terabitesyuex/ENGR1000P2_Mars-Scout-Rover/evidence/hardware/vehicle_assembly_2026-07-23/vehicle_front_right.jpg

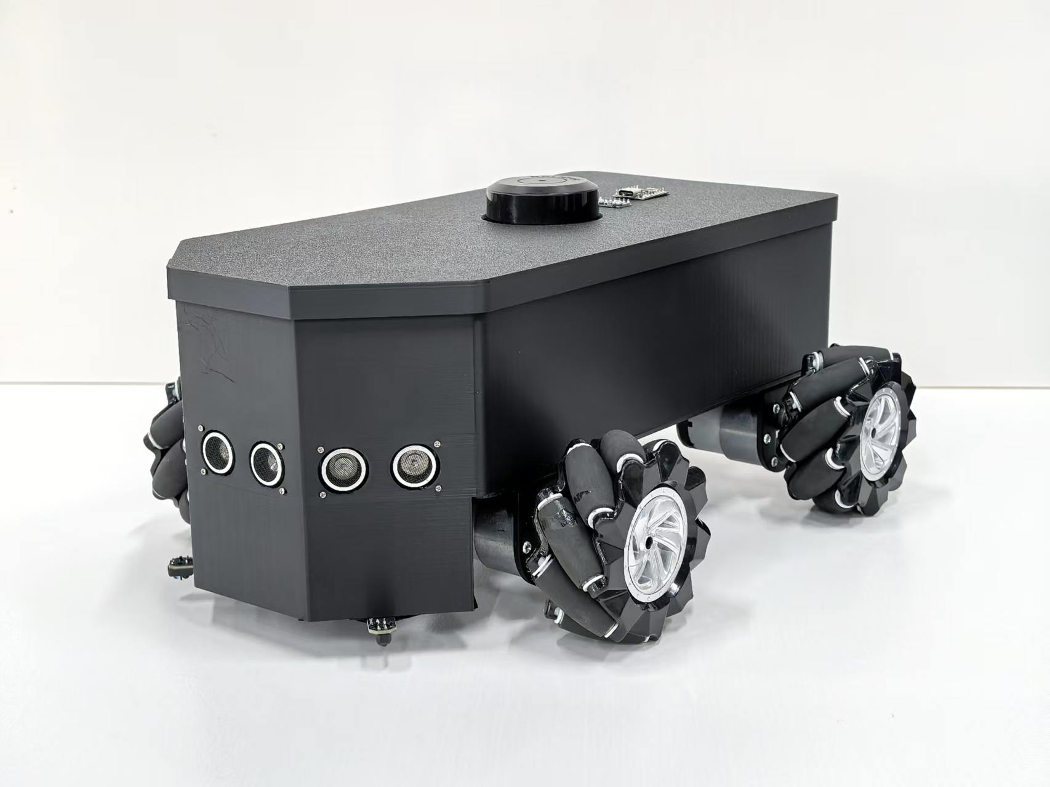
evidence/hardware/vehicle_assembly_2026-07-23/vehicle_front_right.jpg
