terabitesyuex/ENGR1000P2_Mars-Scout-Rover/README.md

# ENGR1000P2 Mars Scout Rover

This repository supports a low-cost Mars Scout Rover using an STM32 mecanum-wheel chassis, an ESP32 communication layer, multiple sensors, and PC visualization/recording tools.

Mandatory baseline functions are nearby-obstacle detection, local stop/turn collision avoidance, rover and sensor data acquisition, WiFi data transmission to a computer, real-time 2D LiDAR/radar-style display, reproducible evidence through recording/replay, and safe behavior when communication or sensors fail.

Major enhancements are encoder/IMU-assisted pose estimation, short-range accumulated 2D environment mapping, and environmental-change indication using illuminance, temperature, and atmospheric-pressure measurements. The current inventory has exactly one physical RPLIDAR C1M1-R2; dual-C1 work is not current scope. ROS and a vehicle-mounted Linux computer are not required.

The user reports that the complete vehicle has been assembled to the wiring
plan. A 2026-07-23 evidence batch records exterior/underside sensor photographs,
vehicle front, installed C1/GY-521, 79 mm wheel diameter, 190 mm wheelbase,
217 mm track width, and an 85.8 mm C1 scan-plane height above the chassis upper
surface. Electrical acceptance, controller wiring, signs, calibration, and
controlled operation remain UNVERIFIED.
The current accelerated scope is a presentation-ready vehicle demo. A supplied
hardware-team obstacle target is being integrated through the fail-closed
[`vehicle demo obstacle guide`](docs/vehicle_demo_obstacle_integration.md).
Formal Phase 4C background remains in
[`docs/near_term_vehicle_bringup_handoff.md`](docs/near_term_vehicle_bringup_handoff.md).

## Repository Layout

- `firmware/openrf1/`: OpenRF1 firmware, isolated bring-up applications, centralized rover configuration, and the embedded motor/encoder/mecanum boundary.
- `firmware/include/` and `firmware/src/`: portable firmware interfaces and transport/processing foundations retained for later integration.
- `pc/`: installable PC tools, parsers, recording/replay, visualization, simulations, and automated tests.
- `pc_direct/`: operator-driven direct C1 diagnostics and the official SDK probe.
- `docs/`, `evidence/`, and `tools/`: current hardware guidance, recorded evidence, and deterministic verification.

装车使用 [`docs/openrf1_rover_wiring_plan_zh.md`](docs/openrf1_rover_wiring_plan_zh.md)；
工程依据和状态边界使用
[`docs/openrf1_rover_wiring_plan.md`](docs/openrf1_rover_wiring_plan.md)。

The repository root is the single source of truth. Historical nested repository copies and README-only future-module placeholders are intentionally excluded.

## Current Phase

- Phase 0: complete.
- Phase 1: complete.
- Phase 2.1: synthetic scan pipeline and unified `ScanFrame` model complete.
- Phase 2.2: rover-frame coordinate transforms complete.
- Automated phase verification foundation: complete.
- Phase 2.3: synthetic LiDAR visualization complete.
- Phase 2.4: multi-sensor JSONL recording, replay, reproducible synthetic datasets, hardware-inventory update, and plan rebaseline complete.
- Phase 2.5: PC-direct C1 driver boundary, standard scan-node parsing, bounded capture into JSONL, replay, visualization, and committed physical-evidence validation complete. The one `c1_1` has MANUAL_EVIDENCE_VERIFIED physical acquisition and external RViz `/scan` visualization; electrical safety, vendor health, wall-clock timing, absolute accuracy, and rover integration remain UNVERIFIED.
- Phase 3.1: STM32 low-rate sensor telemetry protocol, deterministic simulator, strict parser, recording bridge, CLI workflows, and manual bring-up checklist complete.
- Phase 3.2A: OpenRF1 STM32F103RCT6 + GY-302/BH1750 firmware foundation, mocked PC serial-capture workflow, documentation, phase verification, and recorded BH1750-only physical evidence complete. Absolute lux calibration remains UNVERIFIED.
- Phase 3.2B: OpenRF1 multisensor and communications software foundation, isolated full-hardware Keil project, PC contracts, simulators, parser/recording support, and software verification support added. Physical wiring and live sensor/link behavior remain UNVERIFIED.
- Phase 3.2C: isolated OpenRF1 BMP280-only bring-up firmware, Keil target, host-side BMP280 register/telemetry tests, verifier support, and recorded BMP280 physical evidence complete. Absolute temperature and pressure accuracy remain UNVERIFIED.
- Phase 3.2D: isolated OpenRF1 MPU6050-only bring-up firmware foundation, Keil target, host-side MPU6050 register/telemetry tests, verifier support, startup gyro-bias calibration software, and recorded isolated manual evidence complete. Absolute acceleration/gyro accuracy, calibration motion rejection, final rover-frame axis alignment, shared-I2C concurrency, and full-hardware operation remain UNVERIFIED.
- Phase 3.2E: isolated OpenRF1 HC-SR04-only bring-up firmware, bounded telemetry framing, strict parser, dedicated mock capture, fixtures, evidence lifecycle, A/B handoffs, PA5/PA4/CN6/TIM6 vendor-documented design lock, required external ECHO divider, Keil target, tests, and verifier support complete. Physical wiring, trigger/echo pulses, real distance data, timeout behavior, and distance accuracy remain UNVERIFIED.
- Phase 3.2F: isolated OpenRF1 ground-sensor firmware foundation and TCRT5000 evidence closeout complete. A's evidence verifies the isolated build/flash, PC4/PC5 signal connections, labelled 3.3 V/common-GND connections, both modules' raw/debounced response, four 100-frame gap-free captures, and exact 50 ms steady-state timestamps. A later user-supplied photograph confirms the Hall module is mounted under the rover and that the photograph's top edge is rover-forward. Corrected front/rear/left/right Hall-to-body-boundary clearances are 185/135/75/75 mm; supplied 95/95 mm front/rear axle distances and 65 mm floor height establish Hall x=0 mm, y=0 mm, z=+25.5 mm relative to the wheel-centre `base_link`, using the supplied 39.5 mm loaded wheel radius. Electrical measurements, sensing face, polarity semantics, magnetic behavior/working distance, long-duration operation, and full-rover operation remain UNVERIFIED.
- Phase 4A: standard X-layout mecanum kinematics, explicit wheel-side encoder conversion, body-twist estimation, exact SE(2) odometry integration, deterministic simulation, version-1 telemetry/recording compatibility, tests, documentation, and verifier support complete as a software-only foundation. Supplied geometry is recorded at 0.1 mm precision; encoder resolution/signs, roller orientation, hardware acquisition, geometry tolerance, and physical odometry accuracy remain UNVERIFIED.
- Phase 4B: validated body-motion commands, proportional wheel desaturation, acceleration limiting, four independent PID controllers, command watchdog, local safety arbitration, deterministic synthetic wheel plants, version-1 telemetry/recording additions, CLI, tests, documentation, and verifier support complete as a software-only foundation. Real motor/encoder behavior, PWM mapping, physical PID tuning, stopping distance, and closed-loop performance remain UNVERIFIED.
- OpenRF1 rover-control firmware boundary: centralized UNKNOWN hardware mappings, injected four-channel Motor and Encoder HALs, fixed-point mecanum inverse kinematics, and an isolated ARM Compiler 6 compile target are present. The target uses inert backends and must not be flashed as operational rover firmware; real PWM, encoder acquisition, motion, and hardware integration remain UNVERIFIED.
- Accelerated vehicle-demo obstacle foundation: isolated real TIM8 motor output,
  nonblocking staggered three-HC-SR04 acquisition, explicit ARM/START,
  fail-closed sensor handling, command heartbeat watchdog, strict JSONL, focused
  tests, and a dedicated Keil project are present. The current demo mapping is
  user-confirmed as left PB9/PB8, centre PB5/PB4, and right PD2/PC11. All three
  ECHO paths are user-reported operational without dividers, but their actual
  voltages and electrical safety remain unverified. The same target now has a
  read-only four-connector encoder foundation using TIM5/TIM3/TIM2-full-remap/
  TIM4, 50 ms raw/delta/cumulative JSONL, and strict offline inspection. It does
  not assign physical wheel roles or direction signs, and encoder data cannot
  control motion.

Phases 4A and 4B themselves do not implement hardware adapters. VehicleDemo now contains a software-verified read-only timer/counter encoder adapter, but its physical operation is unverified and it is not yet connected to Phase 4A odometry or Phase 4B control. ESP32 WiFi firmware, mapping, SLAM, navigation, C1 integrated-rover validation, MPU6050 fusion, physical closed-loop motion, and full multisensor hardware integration remain incomplete. Automated tests do not access real COM ports, USB devices, GPIO, timer peripherals, I2C, encoders, motors, flashing tools, WiFi, or sensors.

Phase 4C now also has a dedicated `OpenRF1_Encoder_Bringup` firmware and Keil
project. It is USART1-TX-only, samples neutral CN1-CN4 16-bit counters every
100 ms, reuses the strict offline encoder inspector, and contains no TIM8,
motor GPIO, sensor path, or command receiver. The ARM Compiler 6.24 build
completed with 0 errors and 0 warnings. No COM port was opened and nothing was
flashed; see `docs/openrf1_encoder_bringup.md` for the manual gate.

The next software-only subset, `OpenRF1_Motor_Bringup`, is also present. It
starts unconfigured with TIM8 CCR=0, CCER=0, and MOE off; requires one explicit
CN, two signs, a user-reviewed duty ceiling, watchdog, ARM, and RUN; and removes
output on all command/transport/watchdog failures. Its ARM Compiler 6.24 build
also reports 0 errors and 0 warnings. No physical safety or operation is
claimed; see `docs/openrf1_motor_bringup.md`.
The fill-in preflight and evidence form is
`docs/phase4c_manual_test_card_zh.md`.

## Phase 4A Mecanum Kinematics and Odometry

Phase 4A preserves `+x` forward, `+y` left, and positive counterclockwise yaw. It implements the documented standard X-layout equations in wheel order `front_left`, `front_right`, `rear_left`, `rear_right`. Positive wheel rotation is mathematical and independent of physical wiring or encoder polarity.

Callers must explicitly provide finite positive `wheel_radius_m`, `half_length_m`, `half_width_m`, and wheel-side `counts_per_wheel_revolution`, plus four direction multipliers restricted to `+1` or `-1`. No physical geometry, encoder resolution, gear ratio, counter width, or sign is defaulted.

Generate a deterministic fixture using values explicitly labelled synthetic, not rover measurements:

```powershell
python -m rplidar_c1_tools.cli simulate-mecanum-odometry --wheel-radius-m 0.05 --half-length-m 0.18 --half-width-m 0.16 --counts-per-wheel-revolution 2048 --front-left-direction 1 --front-right-direction 1 --rear-left-direction 1 --rear-right-direction 1 --scenario combined_curved_motion --steps 5 --interval-ms 100 --output .verification\phase4a\mecanum_odometry.jsonl --overwrite
```

See `docs/phase4a_mecanum_kinematics_odometry_foundation.md` for formulas, encoder interpretation, SE(2) integration, telemetry/recording fields, and the complete UNVERIFIED hardware boundary.

## Phase 4B Closed-Loop Motion Control

Phase 4B reuses Phase 4A kinematics and adds pure command validation, proportional four-wheel desaturation, per-wheel angular-acceleration limits, derivative-on-measurement PID with conditional anti-windup, four independent controller states, supplied-timestamp watchdog logic, explicit permit-or-stop safety precedence, and a synthetic first-order wheel plant. Normalized effort is dimensionless mathematical output, not PWM or motor voltage.

All geometry, limits, PID values, and plant values used by the CLI are explicit synthetic fixtures:

```powershell
python -m rplidar_c1_tools.cli simulate-motion-control --wheel-radius-m 0.05 --half-length-m 0.18 --half-width-m 0.16 --max-wheel-speed-rad-s 20 --wheel-acceleration-rad-s2 10 --pid-kp 0.05 --pid-ki 0.02 --pid-kd 0 --pid-output-min -1 --pid-output-max 1 --pid-integral-min -2 --pid-integral-max 2 --plant-gain-rad-s-per-effort 20 --plant-time-constant-s 0.2 --command-timeout-ms 250 --scenario combined_curved_motion --steps 20 --interval-ms 100 --output .verification\phase4b\motion_control.jsonl --overwrite
```

See `docs/phase4b_closed_loop_motion_control_foundation.md` for equations, safety precedence, telemetry additions, simulator scenarios, and the UNVERIFIED physical boundary.

## Confirmed Hardware Inventory

Ranging:

- RPLIDAR C1M1-R2 x1.
- HC-SR04 ultrasonic sensor x3.

Motion and pose:

- Wheel encoders associated with four drive motors.
- MPU6050 inertial measurement unit x1.

Ground and landmark:

- TCRT5000 reflective infrared sensor x2 for edge/drop detection.
- Hall sensor module x1 for magnetic landmark/checkpoint detection.

Environment:

- BH1750 illuminance sensor x1.
- BMP280 temperature/pressure sensor x1.

Controllers and chassis:

- STM32 controller board x1.
- ESP32 board x1.
- Li-ion battery pack x1: seller-documented 11.1 V, 7800 mAh, 5C, 12.6 V fully
  charged, 70 x 55 x 23 mm, DC 5.5 x 2.5 mm male connector; polarity and BMS
  current limits remain UNVERIFIED.
- Battery charger x1: seller-documented 12.6 V/1 A, DC 5.5 x 2.5 mm female;
  charge only while the pack is disconnected from the rover.
- Four encoded motors.
- Four mecanum wheels.
- Existing rover chassis.
- Supplied geometry record: 79 mm loaded wheel diameter, 190 mm wheelbase,
  217 mm track width. These are not yet physically tolerance-calibrated.

Use neutral sensor IDs until installation is physically verified: `c1_1`, `ultrasonic_1`, `ultrasonic_2`, `ultrasonic_3`, `tcrt5000_1`, `tcrt5000_2`, `bh1750_1`, `bmp280_1`, `mpu6050_1`, and `hall_1`. Historical version-1 recordings and explicitly synthetic compatibility fixtures may contain `c1_2`.

Exactly one physical RPLIDAR C1M1-R2 is available. `c1_1` is the only current physical LiDAR sensor and the only active LiDAR integration target. PC-direct acquisition and visualization are MANUAL_EVIDENCE_VERIFIED; full physical acceptance remains partial. There is no current requirement to compare two physical units, no current dual-C1 integration phase, and no current dual-C1 feasibility evaluation. A future second C1 requires an explicit inventory change and new electrical, power, UART, bandwidth, buffering, timing, mounting, synchronization, and safety validation.

Committed Phase 2.5 evidence preserves 102 physical scan records containing 36,720 points plus a hash-locked RViz screenshot. Offline validation confirms schema, identity, sequence, point shape, hashes, and privacy without opening a serial port. The capture timestamps are tool-generated, and the raw bundle retains quality-zero and above-12 m outliers, so scan timing, clean-packet rate, absolute accuracy, electrical safety, and integrated operation remain UNVERIFIED.

## Phase 3.1 STM32 Sensor Telemetry

Phase 3.1 defines the transport-facing protocol `mars_scout_stm32_sensor_telemetry` version `1` for future STM32 low-rate sensor messages. It is newline-delimited UTF-8 JSON for software bring-up and later ESP32 forwarding. The persistent PC recording format remains `mars_scout_multisensor_recording` version `1`.

Generate deterministic STM32 telemetry:

```powershell
python -m rplidar_c1_tools.cli simulate-stm32-sensors --cycles 5 --scenario nominal --output .verification\phase3.1\synthetic_stm32_telemetry.jsonl --overwrite
```

Inspect telemetry:

```powershell
python -m rplidar_c1_tools.cli inspect-stm32-telemetry --input .verification\phase3.1\synthetic_stm32_telemetry.jsonl --output .verification\phase3.1\telemetry_inspection.txt
```

Convert telemetry into the existing Phase 2.4 recording format:

```powershell
python -m rplidar_c1_tools.cli record-stm32-telemetry --input .verification\phase3.1\synthetic_stm32_telemetry.jsonl --output .verification\phase3.1\converted_multisensor_recording.jsonl --overwrite
```

Supported Phase 3.1 sensor message types are `ultrasonic`, `ground_edge`, `hall_landmark`, `illuminance`, and `barometer`. HC-SR04 timeout is explicit and is not converted to distance zero. TCRT5000 and Hall raw states remain visible while polarity is UNVERIFIED. BH1750 and BMP280 support environmental-change indication only; reliable dust-storm detection is not claimed.

## Phase 3.2A OpenRF1 BH1750 Foundation

Phase 3.2A locks the software target for the first real STM32 sensor path: OpenRF1 robot controller, STM32F103RCT6, software I2C on PB1/SCL and PC3/SDA, GY-302/BH1750 sensor ID `bh1750_1`, public 7-bit address `0x23`, and USART1 PA9 TX / PA10 RX at 115200 baud 8N1. Recorded manual evidence marks firmware flash, CH340/USART1 telemetry, BH1750 communication at configured address `0x23`, a 500 ms telemetry period, and physical light response as MANUAL_EVIDENCE_VERIFIED; absolute lux calibration remains UNVERIFIED.

Generate deterministic BH1750-only telemetry:

```powershell
python -m rplidar_c1_tools simulate-bh1750-telemetry --samples 5 --output .verification\phase3.2a\mocked_bh1750_source.jsonl --overwrite
```

Capture from a mocked serial source and convert to the Phase 2.4 recording format:

```powershell
python -m rplidar_c1_tools capture-stm32-serial --mock-input .verification\phase3.2a\mocked_bh1750_source.jsonl --max-messages 5 --telemetry-output .verification\phase3.2a\mocked_bh1750_telemetry.jsonl --recording-output .verification\phase3.2a\mocked_bh1750_recording.jsonl --overwrite
```

Manual capture requires an operator-selected CH340 COM port; software never guesses a port:

```powershell
python -m rplidar_c1_tools capture-stm32-serial --port <USER_VERIFIED_COM_PORT> --baud 115200 --duration 30 --telemetry-output bh1750_telemetry.jsonl --recording-output bh1750_recording.jsonl --overwrite
```

Firmware source lives under `firmware/openrf1/app/`. It is application-layer source for the vendor OpenRF1 Keil MDK/uVision 5 STM32F103RC project. The committed Phase 3.2A evidence validates a manually recorded BH1750-only run; automated tests still use mocked/file-backed inputs and do not physically access the device.

## Phase 3.2B OpenRF1 Full-Hardware Foundation

Phase 3.2B keeps the Phase 3.2A BH1750-only project intact and adds a separate full-hardware firmware foundation under `firmware/openrf1/full_hardware/` with project file `firmware/openrf1/keil/OpenRF1_FullHardware.uvprojx`. The new Keil output is isolated under `Objects_FullHardware/` as `OpenRF1_FullHardware.hex`.

Software foundations include shared software-I2C transactions for BH1750/BMP280/MPU6050, BMP280 and MPU6050 pure conversion logic, raw digital filtering for TCRT5000/Hall, nonblocking HC-SR04 state machines, RPLIDAR C1 USART2 byte transport counters, and a versioned STM32-to-ESP32 USART3 binary frame contract. Phase 3.2B uses module-specific electrical evidence: BH1750 and MPU6050 module VCC -> 5 V, BMP280 and TCRT5000 VCC -> 3.3 V, Hall module -> 5 V with output measurement required, ESP32 external 5 V isolated from USB, and HC-SR04 Echo protection conditional on measured VOH. USART2/USART3 connector-to-MCU pins, PWM channel GPIOs, line-input GPIOs, BMP280/MPU6050 ACKs, polarity, power integrity, and real full-system sensor data remain UNVERIFIED.

Generate a deterministic Phase 3.2B telemetry fixture:

```powershell
python -m rplidar_c1_tools.cli simulate-stm32-sensors --cycles 2 --scenario phase32b_full_foundation --output .verification\phase3.2b\phase32b_full_telemetry.jsonl --overwrite
```

Convert it to the existing recording format:

```powershell
python -m rplidar_c1_tools.cli record-stm32-telemetry --input .verification\phase3.2b\phase32b_full_telemetry.jsonl --output .verification\phase3.2b\phase32b_full_recording.jsonl --overwrite
```

## Phase 3.2C OpenRF1 BMP280 Bring-Up

Phase 3.2C adds a BMP280-only physical bring-up target under `firmware/openrf1/bmp280_bringup/` with Keil project `firmware/openrf1/keil/OpenRF1_BMP280_Bringup.uvprojx`. Its output is isolated under `Objects_BMP280_Bringup/` as `OpenRF1_BMP280_Bringup.hex`.

The dedicated firmware expects only `bmp280_1` on software I2C PB1/SCL and PC3/SDA: VCC -> 3.3 V, GND -> GND, CSB -> 3.3 V for I2C mode, and SDO -> GND for address `0x76`. It probes `0x76`, reads chip ID register `0xD0`, expects `0x58`, reads calibration, writes `config = 0x80`, writes `ctrl_meas = 0x27`, and emits `environmental` JSONL every 500 ms on USART1 PA9/PA10 at 115200 8N1.

Committed evidence in `evidence/phase3.2c/` marks isolated BMP280 firmware flashing, USART1/CH340 JSONL telemetry, I2C ACK at `0x76`, chip ID `0x58`, calibration-register path for compensated output, `ctrl_meas = 0x27` and `config = 0x80` readback, continuous compensated temperature/pressure telemetry, exact 500 ms periodicity, and a stable 30-second capture as PHYSICAL_EVIDENCE_VERIFIED. Repository automation validates the evidence offline; it does not flash, open a COM port, or access hardware.

Absolute temperature accuracy, absolute pressure accuracy, environmental-reference comparison, long-duration operation beyond this capture, full shared-I2C concurrency, and complete full-hardware operation remain UNVERIFIED.

## Phase 3.2D OpenRF1 MPU6050 Bring-Up

Phase 3.2D adds an MPU6050-only firmware target under `firmware/openrf1/mpu6050_bringup/` with Keil project `firmware/openrf1/keil/OpenRF1_MPU6050_Bringup.uvprojx`. Its output is isolated under `Objects_MPU6050_Bringup/` as `OpenRF1_MPU6050_Bringup.hex`.

The dedicated firmware expects only `mpu6050_1` on software I2C PB1/SCL and PC3/SDA: GY-521/MPU6050 VCC -> OpenRF1 5 V, GND -> GND, SCL -> PB1/B1, SDA -> PC3/C3, and AD0 -> GND for address `0x68`. INT, XDA, XCL, and FSYNC remain disconnected for polling bring-up. It probes `0x68`, reads WHO_AM_I register `0x75`, expects `0x68`, writes and reads back `PWR_MGMT_1 = 0x01`, `SMPLRT_DIV = 0x09`, `CONFIG = 0x03`, `GYRO_CONFIG = 0x00`, and `ACCEL_CONFIG = 0x00`, performs a 5000 ms startup warmup and 500-sample gyro-bias calibration, then reads 14-byte IMU bursts every 100 ms on USART1 PA9/PA10 at 115200 8N1.

Recorded manual evidence in `evidence/phase3.2d/` is limited to A's sanitized report of isolated wiring, I2C ACK/address `0x68`, WHO_AM_I `0x68`, isolated configuration readback, live IMU JSON telemetry, startup gyro-bias semantics, approximately 10 Hz telemetry during a 15-second isolated test with no reported sequence loss, and isolated sensor-axis response. Exact electrical measurements, continuity, delay-loop tuning, reproducible build/HEX metadata, exact frame/timing statistics, and exact bias/noise statistics are not verified by this evidence. Absolute acceleration accuracy, absolute angular-rate accuracy, calibration-time motion detection, calibration motion rejection, long-duration thermal drift, final rover-frame alignment, shared-I2C concurrency, complete multisensor firmware operation, complete rover operation, motor-vibration behavior, encoder/IMU fusion, physical odometry accuracy, and ESP32/WiFi integration remain UNVERIFIED.

## Phase 3.2E OpenRF1 HC-SR04 Bring-Up

Phase 3.2E adds an HC-SR04-only firmware target under `firmware/openrf1/hcsr04_bringup/` with Keil project `firmware/openrf1/keil/OpenRF1_HCSR04_Bringup.uvprojx`. Its output is isolated under `Objects_HCSR04_Bringup/` as `OpenRF1_HCSR04_Bringup.hex`. Validation-readiness tooling adds a strict shared-envelope parser, the mockable `capture-openrf1-hcsr04` command, a 512-byte JSONL line contract backed by a 513-byte firmware buffer, deterministic timeout/recovery fixtures, sanitized statistics, and a manual-evidence candidate lifecycle.

AUTHORITATIVE_VENDOR_DOCUMENTED facts from the OpenRF1 vendor control-board package, ultrasonic sensor example, and OpenRF1 schematic revision dated 2024-07-01: CN6 B4B-PH-K-S(LF)(SN), pin 1: VCC_5V, pin 2: GND, pin 3: PA5_TRIG, pin 4: PA4_ECHO; TRIG: PA5; ECHO: PA4; TIM6 with prescaler 71 and period 30000 for nominal 1 us timing.

Do not connect HC-SR04 ECHO directly to CN6 pin 4. The software phase locks the external protection design as HC-SR04 ECHO -> 10 kOhm series resistor -> protected PA4 / CN6-pin-4 node; protected PA4 node -> 15 kOhm resistor -> GND. Physical resistor installation, connector orientation, ECHO voltages, trigger pulse, echo pulse, real distance data, timeout behavior, and absolute distance accuracy remain UNVERIFIED.

The isolated firmware retains bounded synchronous polling for diagnostics; each wait stage may block up to the timeout and one attempt can traverse sequential bounded stages. It is not the final non-blocking multisensor runtime. See `docs/phase3_2e_hcsr04_A_test_card.md` for future manual work and `docs/phase3_2e_hcsr04_B_review_handoff.md` for independent software review. No current Phase 3.2E physical evidence exists; status remains `PHYSICAL_VERIFICATION_REQUIRED`.

## Phase 3.2F OpenRF1 Ground-Sensor Bring-Up

Phase 3.2F adds a ground-sensor-only firmware target under `firmware/openrf1/ground_sensors_bringup/` with Keil project `firmware/openrf1/keil/OpenRF1_GroundSensors_Bringup.uvprojx`. Its output is isolated under `Objects_GroundSensors_Bringup/` as `OpenRF1_GroundSensors_Bringup.hex`.

AUTHORITATIVE_VENDOR_DOCUMENTED facts from the OpenRF1 vendor control-board package, OpenRF1 four-channel tracking example, and OpenRF1 schematic revision dated 2024-07-01: connector pin 1: GND, pin 2: X4 / schematic PC14, pin 3: X3 / PB0, pin 4: X2 / PC5, pin 5: X1 / PC4, pin 6: VCC_5V; signal 1 / X1 / PC4, signal 2 / X2 / PC5, and signal 3 / X3 / PB0. The old example maps X4 to PB1, so signal 4 / X4 is unused and excluded from Phase 3.2F.

The design-locked wiring contract powers both TCRT5000 modules from STM32 3.3 V, powers the Hall module from 5 V, and routes Hall S through the external 10 kOhm / 15 kOhm divider before PB0. Do not connect Hall S directly to PB0. Do not share one VCC rail across all three modules. Runtime telemetry reports numeric `raw_level` and `debounced_level` only; semantic polarity remains unverified.

Sanitized evidence under `evidence/phase3.2f/` records the isolated build and flash plus four 100-frame TCRT captures. Both PC4 and PC5 channels changed in response to the tested reflective-surface/open-space geometry, with no sequence gaps and exact 50 ms steady-state timestamps. This does not validate colour classification, a dependable drop threshold, voltage margins, the Hall channel, or complete-rover behavior.

## Preserved Verified C1 Facts

- Exact model in earlier verified files: SLAMTEC RPLIDAR C1M1-R2.
- Connector: XH2.54-5P housing, four active conductors and one unused position.
- Interface: 3.3 V TTL UART, 460800 baud, 8 data bits, no parity, 1 stop bit.
- Power: regulated 5.0 V supply, 4.8 V to 5.2 V allowed.
- Startup current: approximately 800 mA.
- Typical operating current: approximately 230 mA at 10 Hz.
- Maximum normal operating current: approximately 260 mA.
- Maximum specified supply ripple: 150 mV.
- Motor control: internal closed-loop motor control. There is no external motor PWM conductor.

Do not connect the LiDAR red wire to the ESP32 3.3 V pin. Do not invent GPIO, UART, I2C address, active polarity, connector order, or mounting-offset values.

## System Responsibilities

```text
RPLIDAR C1
    -> ESP32 -> WiFi -> PC visualization/recording

STM32 sensors and rover state
    -> ESP32 -> WiFi -> PC

HC-SR04 / TCRT5000 / relevant local state
    -> STM32 safety decision -> motor control -> rover motion

rover motion
    -> encoders / MPU6050 / sensors -> STM32 -> ESP32 -> PC
```

STM32 owns planned low-level motor safety and low-rate sensor acquisition. ESP32 is the planned WiFi/data bridge. PC software owns visualization, recording, replay, export, and later short-range accumulated mapping.

## Coordinate Convention

- `ScanPoint.angle_deg`: degrees, `0` forward, positive counterclockwise.
- `ScanPoint.distance_mm`: millimetres.
- Cartesian distances: metres.
- `+x`: rover forward.
- `+y`: rover left.
- Native C1 clockwise angles must be converted before `ScanFrame` creation.

Phase 2.3 polar view shows zero degrees at the top and positive angles counterclockwise. The point-cloud display shows rover forward at image top and rover left at image left.

## Recording And Replay

Phase 2.4 implements a human-readable, streamable UTF-8 JSON Lines format named `mars_scout_multisensor_recording` version `1`. The first line is a header containing the sensor inventory. Each following line is one complete record.

Create the current one-C1 room session with auxiliary synthetic streams:

```powershell
python -m rplidar_c1_tools.cli record-synthetic --scene room --frames 3 --lidar-count 1 --include-aux --output .verification\phase2.4\synthetic_multisensor_room.jsonl
```

Inspect the recording:

```powershell
python -m rplidar_c1_tools.cli inspect-recording .verification\phase2.4\synthetic_multisensor_room.jsonl --output .verification\phase2.4\inspection.txt
```

Replay immediately:

```powershell
python -m rplidar_c1_tools.cli replay-recording .verification\phase2.4\synthetic_multisensor_room.jsonl
```

Render final replayed frames:

```powershell
python -m rplidar_c1_tools.cli render-recording .verification\phase2.4\synthetic_multisensor_room.jsonl --output-dir .verification\phase2.4
```

Generated recordings and figures under `.verification/` are ignored by Git.

## PC-Direct C1 Capture

Phase 2.5 adds `capture-c1`. Manual hardware capture requires a user-verified serial port; no COM port is guessed:

```powershell
python -m rplidar_c1_tools.cli capture-c1 --sensor-id c1_1 --port <USER_VERIFIED_PORT> --frames 1 --points-per-frame 360 --output data\raw\c1_1_pc_direct.jsonl
```

Automated verification uses safe hex fixture bytes instead of serial access:

```powershell
python -m rplidar_c1_tools.cli capture-c1 --sensor-id c1_1 --sample-hex 3d0100a00f3e012da00f3e015aa00f3e0187a00f --frames 1 --points-per-frame 4 --output .verification\phase2.5\c1_1_pc_direct_capture.jsonl
```

Captured files use the existing `mars_scout_multisensor_recording` JSONL schema. The driver converts native C1 clockwise angles into the project rover-frame `ScanPoint.angle_deg` convention before recording.

The committed physical evidence and its exact limitations are documented in `evidence/phase2.5/c1_1_physical_evidence.md`. ROS2/RViz is retained only as external diagnostic evidence; ROS2 is not a baseline runtime dependency.

## Phase Verification

Supported phases include `phase1`, `phase2.1`, `phase2.2`, `phase2.3`, `phase2.4`, `phase2.5`, `phase3.1`, `phase3.2a`, `phase3.2b`, `phase3.2c`, `phase3.2d`, `phase3.2e`, `phase3.2f`, `phase4a`, and `phase4b`.

Development verification:

```powershell
.\tools\verify_phase.cmd phase2.5 -AllowDirty
.\tools\verify_phase.cmd phase3.1 -AllowDirty
.\tools\verify_phase.cmd phase3.2a -AllowDirty
.\tools\verify_phase.cmd phase3.2b -AllowDirty
.\tools\verify_phase.cmd phase3.2c -AllowDirty
.\tools\verify_phase.cmd phase3.2d -AllowDirty
.\tools\verify_phase.cmd phase3.2e -AllowDirty
.\tools\verify_phase.cmd phase3.2f -AllowDirty
.\tools\verify_phase.cmd phase4a -AllowDirty
.\tools\verify_phase.cmd phase4b -AllowDirty
```

Normal verification after commit and push:

```powershell
.\tools\verify_phase.cmd phase2.5
.\tools\verify_phase.cmd phase3.1
.\tools\verify_phase.cmd phase3.2a
.\tools\verify_phase.cmd phase3.2b
.\tools\verify_phase.cmd phase3.2c
.\tools\verify_phase.cmd phase3.2d
.\tools\verify_phase.cmd phase3.2e
.\tools\verify_phase.cmd phase3.2f
.\tools\verify_phase.cmd phase4a
.\tools\verify_phase.cmd phase4b
```

The verifier checks Git state, Python selection, pytest import, targeted tests, regressions, the complete PC suite, and configured smoke workflows. Hardware and safety facts still require physical verification.

## Revised Roadmap

- Phase 2.4: multi-sensor recording, replay, reproducible datasets, current hardware inventory update, and project-plan rebaseline.
- Phase 2.5: PC-direct acquisition, recording, replay, visualization, and committed evidence validation for one physical `c1_1`; acquisition is MANUAL_EVIDENCE_VERIFIED while electrical, timing, absolute-accuracy, final-mounting, and integrated-rover acceptance remain unverified.
- Phase 3.1: STM32 low-rate sensor telemetry software foundation, deterministic simulator, PC parser, recording bridge, and manual bring-up checklist.
- Phase 3.2A: OpenRF1 STM32F103RCT6 + GY-302/BH1750 firmware foundation, mocked serial-capture workflow, and manual bring-up procedure.
- Phase 3.2B: OpenRF1 multisensor and communications software foundation; physical integration remains future manual validation.
- Phase 3.2C: OpenRF1 BMP280-only physical bring-up firmware and recorded isolated BMP280 evidence; absolute accuracy and full shared-bus operation remain unverified.
- Phase 3.2D: OpenRF1 MPU6050-only software bring-up firmware and isolated manual evidence; absolute accuracy, calibration motion rejection, shared-I2C concurrency, full multisensor firmware, final installed orientation, and rover integration remain unverified.
- Phase 3.2E: OpenRF1 HC-SR04-only software bring-up firmware; physical wiring, pulses, real distance data, timeout behavior, and accuracy remain unverified.
- Phase 3.2F: OpenRF1 ground-sensor-only firmware and isolated TCRT5000 evidence; electrical measurements, semantic polarity, black/white/drop classification, Hall behavior, and full-hardware operation remain unverified.
- Phase 4A: software-only mecanum kinematics, explicit encoder conversion, deterministic body-twist estimation, and SE(2) odometry foundation.
- Phase 4B: software-only closed-loop wheel-speed control, command shaping, watchdog, local safety arbitration, and deterministic synthetic wheel-plant foundation.
- Phase 4C: encoder observation and fail-disabled one-wheel motor firmware are software-verified; real encoder observation, powered motor bring-up, physical direction discovery, electrical validation, and timer/interrupt/PWM validation remain.
- Later Phase 4 hardware/control work: wheel encoder acquisition, measured geometry/sign configuration, MPU6050 integration, motor control, closed-loop motion, calibration, and physical odometry validation.
- Phase 5: STM32-ESP32-computer communication, WiFi transport, and one-C1 baseline integration. A second C1 is a future out-of-scope extension requiring a new inventory and feasibility review.
- Phase 6: real-time PC visualization, rover trajectory, and short-range encoder/IMU-assisted accumulated 2D mapping.
- Phase 7: local autonomous obstacle stop/turn behavior.
- Phase 8: full Mars-like venue integration, environmental experiments, validation, reliability testing, and final presentation evidence.

Optional future extensions, not current requirements: reusable global SLAM mapping, loop closure, global path planning, autonomous frontier exploration, ROS, ROS 2, Nav2, AMCL, Gmapping, `slam_toolbox`, Raspberry Pi, Jetson, and vehicle-mounted Linux computers.
