terabitesyuex/ENGR1000P2_Mars-Scout-Rover/pc/README.md

# RPLIDAR C1 PC Tools

PC-side package for synthetic scans, coordinate transforms, visualization, Phase 2.4 multi-sensor recording, deterministic replay, Phase 2.5 PC-direct C1 capture, Phase 3.1 STM32 telemetry simulation/parsing/recording bridge, Phase 3.2A OpenRF1 BH1750 mocked serial capture, Phase 3.2B multisensor/link fixtures, and later mapping work.

Phase 2.5 live-driver tests use mocked C1 byte streams only. The package also validates committed physical `c1_1` JSONL and RViz evidence offline by hash and structure. It does not invent ports, access STM32/ESP32 firmware, use WiFi sockets, implement mapping, implement SLAM, or implement obstacle avoidance.

Phase 3.1 STM32 telemetry tools use deterministic files and in-memory streams only. They do not open serial ports, GPIO, I2C, USB devices, timers, or network sockets.

Phase 3.2A capture tools use file-backed mock input in automated tests. Manual live capture requires an explicit user-selected CH340 COM port; no COM port is guessed.

Phase 3.2B tools use deterministic fixtures and pure codecs only. They do not open USART2, USART3, real COM ports, USB devices, WiFi sockets, GPIO, I2C, flashing tools, or sensors.

Phase 3.2F adds offline validation for four sanitized TCRT5000 captures under `evidence/phase3.2f/`. The validator checks hashes, strict JSONL shape, contiguous sequences, and exact 50 ms steady-state timestamps; it does not open a port or infer black/white/drop semantics. The only current physical C1 is `c1_1`.

## Install For Development

```powershell
python -m pip install -e .\pc
```

## Synthetic Scan Output

```powershell
python -m rplidar_c1_tools.cli synthetic-room --scans 1
```

## Synthetic Visualization

```powershell
python -m rplidar_c1_tools.cli render-synthetic --scene both --output-dir .verification\phase2.3_visuals --no-show
```

## Multi-Sensor Recording

One-LiDAR synthetic session:

```powershell
python -m rplidar_c1_tools.cli record-synthetic --scene room --frames 2 --lidar-count 1 --output .verification\phase2.4\one_c1_room.jsonl
```

Two-LiDAR synthetic session with auxiliary streams:

```powershell
python -m rplidar_c1_tools.cli record-synthetic --scene room --frames 3 --lidar-count 2 --include-aux --output .verification\phase2.4\synthetic_multisensor_room.jsonl
```

Auxiliary synthetic streams include optional rover pose, MPU6050-style IMU samples, HC-SR04-style ultrasonic samples, TCRT5000 edge samples, Hall landmark samples, BH1750 illuminance samples, and BMP280 temperature/pressure samples. These are deterministic software fixtures, not hardware measurements.

## Inspection

```powershell
python -m rplidar_c1_tools.cli inspect-recording .verification\phase2.4\synthetic_multisensor_room.jsonl --output .verification\phase2.4\inspection.txt
```

## Replay

Immediate replay:

```powershell
python -m rplidar_c1_tools.cli replay-recording .verification\phase2.4\synthetic_multisensor_room.jsonl
```

Filter one C1:

```powershell
python -m rplidar_c1_tools.cli replay-recording .verification\phase2.4\synthetic_multisensor_room.jsonl --sensor-id c1_1
```

## Render From Replay

```powershell
python -m rplidar_c1_tools.cli render-recording .verification\phase2.4\synthetic_multisensor_room.jsonl --output-dir .verification\phase2.4
```

Expected output names include:

- `c1_1_last_polar.png`
- `c1_1_last_point_cloud.png`
- Historical or explicitly synthetic compatibility renders may also use `c1_2_last_polar.png` and `c1_2_last_point_cloud.png`; these are not current physical evidence.

## PC-Direct C1 Capture

Manual capture requires a user-verified port:

```powershell
python -m rplidar_c1_tools.cli capture-c1 --sensor-id c1_1 --port <USER_VERIFIED_PORT> --frames 1 --points-per-frame 360 --output .verification\phase2.5\c1_1_pc_direct.jsonl
```

Automated smoke capture uses fixture bytes and opens no serial port:

```powershell
python -m rplidar_c1_tools.cli capture-c1 --sensor-id c1_1 --sample-hex 3d0100a00f3e012da00f3e015aa00f3e0187a00f --frames 1 --points-per-frame 4 --read-chunk-size 5 --output .verification\phase2.5\c1_1_fixture.jsonl --overwrite
```

The output is the same Phase 2.4 JSONL schema used by `inspect-recording`, `replay-recording`, and `render-recording`.

## STM32 Sensor Telemetry

```powershell
python -m rplidar_c1_tools.cli simulate-stm32-sensors --cycles 5 --scenario nominal --output .verification\phase3.1\synthetic_stm32_telemetry.jsonl --overwrite
python -m rplidar_c1_tools.cli inspect-stm32-telemetry --input .verification\phase3.1\synthetic_stm32_telemetry.jsonl --output .verification\phase3.1\telemetry_inspection.txt
python -m rplidar_c1_tools.cli record-stm32-telemetry --input .verification\phase3.1\synthetic_stm32_telemetry.jsonl --output .verification\phase3.1\converted_multisensor_recording.jsonl --overwrite
```

Protocol: `mars_scout_stm32_sensor_telemetry` version `1`.

Supported scenarios: `nominal`, `ultrasonic_timeout`, `ground_polarity_unverified`, `hall_polarity_unverified`, `environment_change`, and `mixed_faults`.

## OpenRF1 BH1750 Serial Capture

Generate BH1750-only mock telemetry:

```powershell
python -m rplidar_c1_tools simulate-bh1750-telemetry --samples 5 --output .verification\phase3.2a\mocked_bh1750_source.jsonl --overwrite
```

Capture through the mocked serial path and convert to a Phase 2.4 recording:

```powershell
python -m rplidar_c1_tools capture-stm32-serial --mock-input .verification\phase3.2a\mocked_bh1750_source.jsonl --max-messages 5 --telemetry-output .verification\phase3.2a\mocked_bh1750_telemetry.jsonl --recording-output .verification\phase3.2a\mocked_bh1750_recording.jsonl --overwrite
```

Manual live capture requires a user-verified port:

```powershell
python -m rplidar_c1_tools capture-stm32-serial --port <USER_VERIFIED_COM_PORT> --baud 115200 --duration 30 --telemetry-output bh1750_telemetry.jsonl --recording-output bh1750_recording.jsonl --overwrite
```

The live serial reader sets DTR and RTS low before opening pyserial, which avoids an avoidable CH340 reset pulse on boards that expose those control lines. The capture loop allows a default 12-second startup grace period before the first valid line; adjust it with `--startup-grace-s` only when the operator has a specific reason. Malformed BH1750 telemetry lines are counted and skipped, and each valid frame resets the consecutive-malformed counter. Capture fails after 5 consecutive malformed lines by default, or when the source ends without any valid message; use `--max-consecutive-malformed-lines` to set a different positive limit. Invalid byte encoding, oversized lines, and read timeouts remain fatal.

If pyserial is unavailable for manual live capture, install it only in the repository virtual environment:

```powershell
pc\.venv\Scripts\python.exe -m pip install pyserial
```

## Phase 3.2B Full-Hardware Fixtures

```powershell
python -m rplidar_c1_tools.cli simulate-stm32-sensors --cycles 2 --scenario phase32b_full_foundation --output .verification\phase3.2b\phase32b_full_telemetry.jsonl --overwrite
python -m rplidar_c1_tools.cli record-stm32-telemetry --input .verification\phase3.2b\phase32b_full_telemetry.jsonl --output .verification\phase3.2b\phase32b_full_recording.jsonl --overwrite
python -m rplidar_c1_tools.cli inspect-recording .verification\phase3.2b\phase32b_full_recording.jsonl --output .verification\phase3.2b\phase32b_recording_inspection.txt
```

The fixture includes `imu_raw`, `subsystem_status`, `link_status`, and `lidar_transport_stats`. These records are software diagnostics, not physical sensor evidence.

## Phase 4A Mecanum Odometry Simulation

All geometry, wheel-side encoder resolution, and four direction signs are required. These example values are synthetic fixtures, not rover measurements:

```powershell
python -m rplidar_c1_tools.cli simulate-mecanum-odometry --wheel-radius-m 0.05 --half-length-m 0.18 --half-width-m 0.16 --counts-per-wheel-revolution 2048 --front-left-direction 1 --front-right-direction 1 --rear-left-direction 1 --rear-right-direction 1 --scenario combined_curved_motion --steps 5 --interval-ms 100 --output .verification\phase4a\mecanum_odometry.jsonl --overwrite
python -m rplidar_c1_tools.cli inspect-stm32-telemetry --input .verification\phase4a\mecanum_odometry.jsonl --output .verification\phase4a\telemetry_inspection.txt
python -m rplidar_c1_tools.cli record-stm32-telemetry --input .verification\phase4a\mecanum_odometry.jsonl --output .verification\phase4a\mecanum_recording.jsonl --overwrite
```

This workflow opens no hardware and does not prove physical odometry accuracy.

## Phase 4B Motion-Control Simulation

`simulate-motion-control` runs the hardware-free Phase 4B command-shaping, watchdog/safety, independent PID, synthetic first-order wheel-plant, and Phase 4A forward-kinematics pipeline. Geometry, limits, gains, output/integral bounds, plant parameters, timeout, steps, and interval are explicit synthetic inputs. Output is additive version-1 JSONL and overwrite is refused unless requested.

```powershell
python -m rplidar_c1_tools.cli simulate-motion-control --wheel-radius-m 0.05 --half-length-m 0.18 --half-width-m 0.16 --max-wheel-speed-rad-s 20 --wheel-acceleration-rad-s2 10 --pid-kp 0.05 --pid-ki 0.02 --pid-kd 0 --pid-output-min -1 --pid-output-max 1 --pid-integral-min -2 --pid-integral-max 2 --plant-gain-rad-s-per-effort 20 --plant-time-constant-s 0.2 --command-timeout-ms 250 --scenario combined_curved_motion --steps 20 --interval-ms 100 --output .verification\phase4b\motion_control.jsonl --overwrite
```

These values are not rover measurements or usable physical PID tuning. The command never opens serial ports or accesses hardware.

## Data Location

Generated development artifacts belong under `.verification/`, which is ignored by Git. Do not commit generated recordings or figures unless a future task explicitly asks for a curated fixture.

## Tests

```powershell
pc\.venv\Scripts\python.exe -m pytest pc\tests\test_recording.py pc\tests\test_replay.py pc\tests\test_current_plan.py -v
pc\.venv\Scripts\python.exe -m pytest pc\tests\test_stm32_sensor_models.py pc\tests\test_stm32_sensor_protocol.py pc\tests\test_stm32_sensor_simulator.py pc\tests\test_stm32_recording_bridge.py pc\tests\test_stm32_sensor_cli.py pc\tests\test_phase3_current_plan.py -v
pc\.venv\Scripts\python.exe -m pytest pc\tests\test_openrf1_bh1750.py pc\tests\test_openrf1_firmware_foundation.py pc\tests\test_stm32_serial_capture.py -v
pc\.venv\Scripts\python.exe -m pytest pc\tests -v
pc\.venv\Scripts\python.exe -m pytest pc\tests\test_mecanum_kinematics_odometry.py pc\tests\test_mecanum_odometry_simulator.py pc\tests\test_mecanum_odometry_cli.py -v
pc\.venv\Scripts\python.exe -m pytest pc\tests\test_motion_control.py pc\tests\test_motion_control_simulator.py pc\tests\test_motion_control_cli.py pc\tests\test_phase4b_foundation.py -v
```

Phase verifier:

```powershell
.\tools\verify_phase.cmd phase2.5 -AllowDirty
.\tools\verify_phase.cmd phase3.1 -AllowDirty
.\tools\verify_phase.cmd phase3.2a -AllowDirty
.\tools\verify_phase.cmd phase4a -AllowDirty
.\tools\verify_phase.cmd phase4b -AllowDirty
```
