terabitesyuex/ENGR1000P2_Mars-Scout-Rover/evidence/phase2.5/c1_1_physical_evidence.md

# Phase 2.5 Physical `c1_1` Evidence

## Provenance

- Evidence received: 2026-07-22.
- Physical sensor ID: `c1_1`.
- User-reported model: RPLIDAR C1M1-R2.
- Source session repository commit: `db9fbb78e902df3d4b6ab05b4dd7eec356079160`.
- Source ZIP SHA-256: `C28F5B0E9C3E6BC45F39E0C16A2EA90AA1555CB023064A427814F37CC8F109B6`.
- RViz screenshot SHA-256: `A4B56A61B62D43F870F7937488D9D7C85691B54DD0CE3268389618C679FE6A03`.
- The source archive itself is not committed. The eight JSONL captures are preserved byte-for-byte, and generated duplicate render images are omitted.
- No local path, concrete COM port, or unredacted serial identifier is committed.

## Offline-Validated Dataset

| Capture | Scan records | Points | Purpose |
|-|-:|-:|-|
| `c1_1_live_1x360.jsonl` | 1 | 360 | live single-frame capture |
| `c1_1_pc_direct_1x360.jsonl` | 1 | 360 | PC-direct single-frame capture |
| `c1_1_stability_50x360.jsonl` | 50 | 18,000 | bounded multi-frame capture |
| `c1_1_target_500mm.jsonl` | 10 | 3,600 | user-reported 500 mm target smoke test |
| `c1_1_target_1000mm.jsonl` | 10 | 3,600 | user-reported 1000 mm target smoke test |
| `c1_1_target_2000mm.jsonl` | 10 | 3,600 | user-reported 2000 mm target smoke test |
| `c1_1_target_left.jsonl` | 10 | 3,600 | user-reported temporary direction smoke test |
| `c1_1_target_right.jsonl` | 10 | 3,600 | user-reported temporary direction smoke test |

The committed bundle contains 102 scan records and 36,720 points. Every scan has 360 points, uses sensor ID `c1_1`, follows `mars_scout_multisensor_recording` version 1, and has contiguous sequence values within its capture. Hashes, record shape, point ranges, and privacy checks are enforced by `phase25_evidence.py`.

The record timestamps are generated by the capture tool at a nominal 100,000 us frame step. They are not wall-clock measurements and do not verify scan frequency, elapsed capture time, transport latency, or dropped-sample rate.

## MANUAL_EVIDENCE_VERIFIED

- The one physical `c1_1` produced data accepted by the repository PC-direct acquisition and recording path.
- A bounded 50 x 360 capture completed and produced 50 contiguous repository records containing 18,000 decoded points.
- The source session reported successful inspection, replay, polar rendering, point-cloud rendering, target-response smoke tests at 500 mm, 1000 mm, and 2000 mm, and temporary left/right orientation response.
- The supplied screenshot shows visible laser returns in RViz with fixed frame `laser` and LaserScan topic `/scan`.
- ROS2/RViz is external diagnostic evidence. It does not add ROS2 as a baseline runtime dependency and does not replace the repository recording, replay, or visualization path.

## Data-Quality Boundary

The locked captures include 41 points with quality 0 and 132 points above 12,000 mm, with a maximum recorded distance of 16,360 mm. They are retained as raw evidence rather than silently filtered. This means the evidence verifies physical acquisition and visible geometric response, but not clean-packet rate, production filtering, or manufacturer-grade range behavior.

## Still UNVERIFIED

- Supply voltage, polarity, current margin, ripple, and common-ground measurements.
- Vendor-tool device information, health state, scan mode, and measured scan frequency.
- Exact serial identifier and hardware revision.
- Wall-clock scan timing, corrupt-node rate, dropped-sample rate, and long-duration stability.
- Controlled reference geometry, uncertainty, absolute range accuracy, angular calibration, and repeatability.
- Final rover mounting position, yaw, and `base_link` transform.
- STM32/OpenRF1 transport, ESP32/WiFi transport, and full-rover operation.

Repository automation validates only committed files and opens no serial port, accesses no hardware, and flashes nothing.
