terabitesyuex/ENGR1000P2_Mars-Scout-Rover/evidence/hardware/battery/battery_11v1_7800mah_5c.jpg

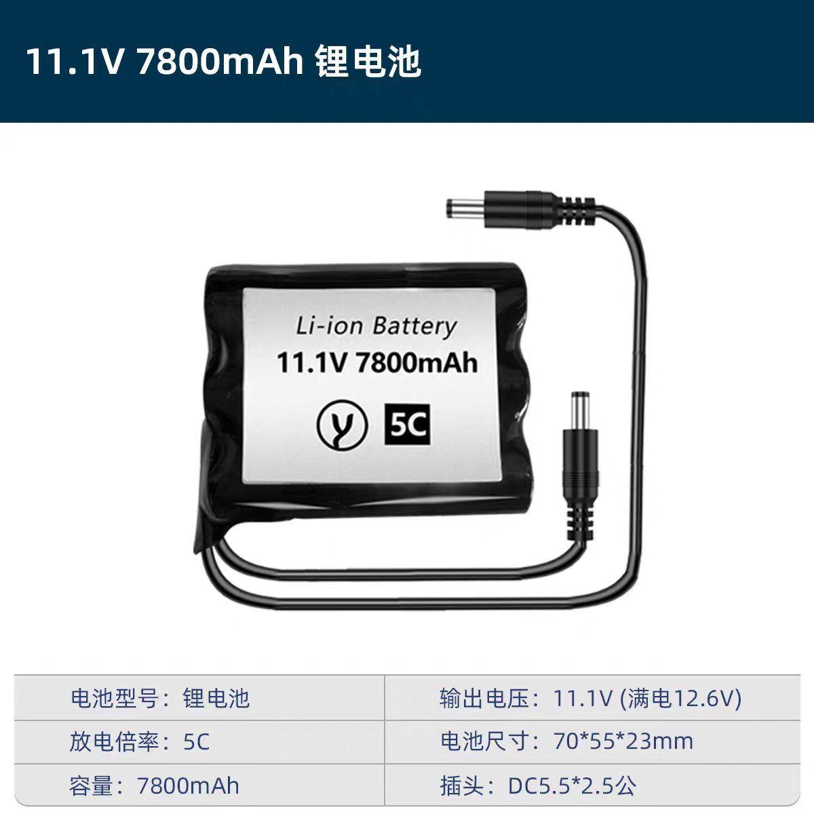
evidence/hardware/battery/battery_11v1_7800mah_5c.jpg
