terabitesyuex/ENGR1000P2_Mars-Scout-Rover/evidence/hardware/battery/battery_product_family_specs.jpg

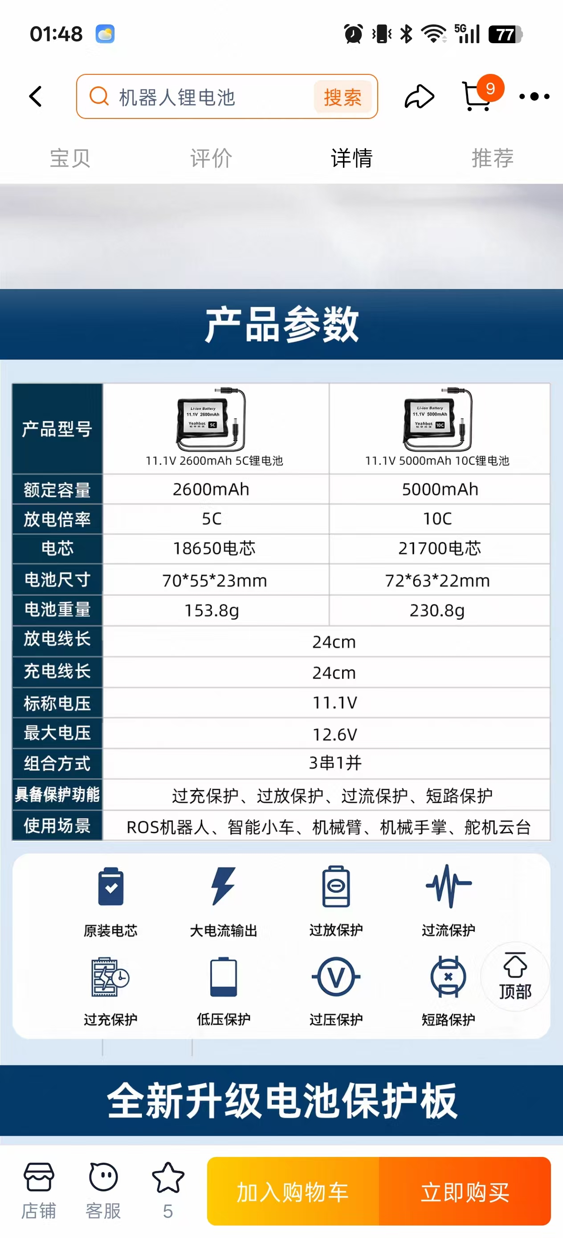
evidence/hardware/battery/battery_product_family_specs.jpg
