terabitesyuex/ENGR1000P2_Mars-Scout-Rover/evidence/hardware/battery/charger_12v6_1a.jpg

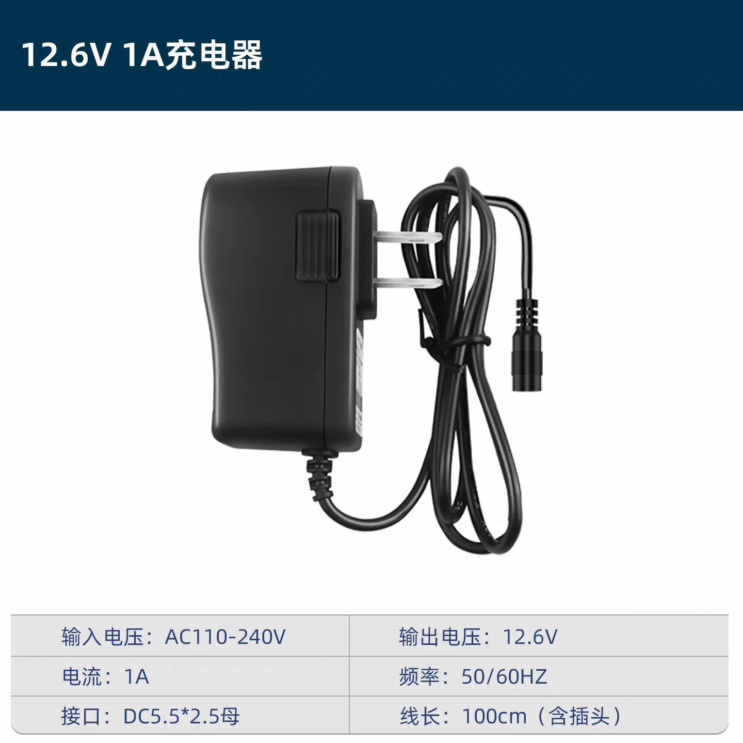
evidence/hardware/battery/charger_12v6_1a.jpg
