terabitesyuex/ENGR1000P2_Mars-Scout-Rover/evidence/phase2.5/c1_1_ros2_rviz_laserscan.png

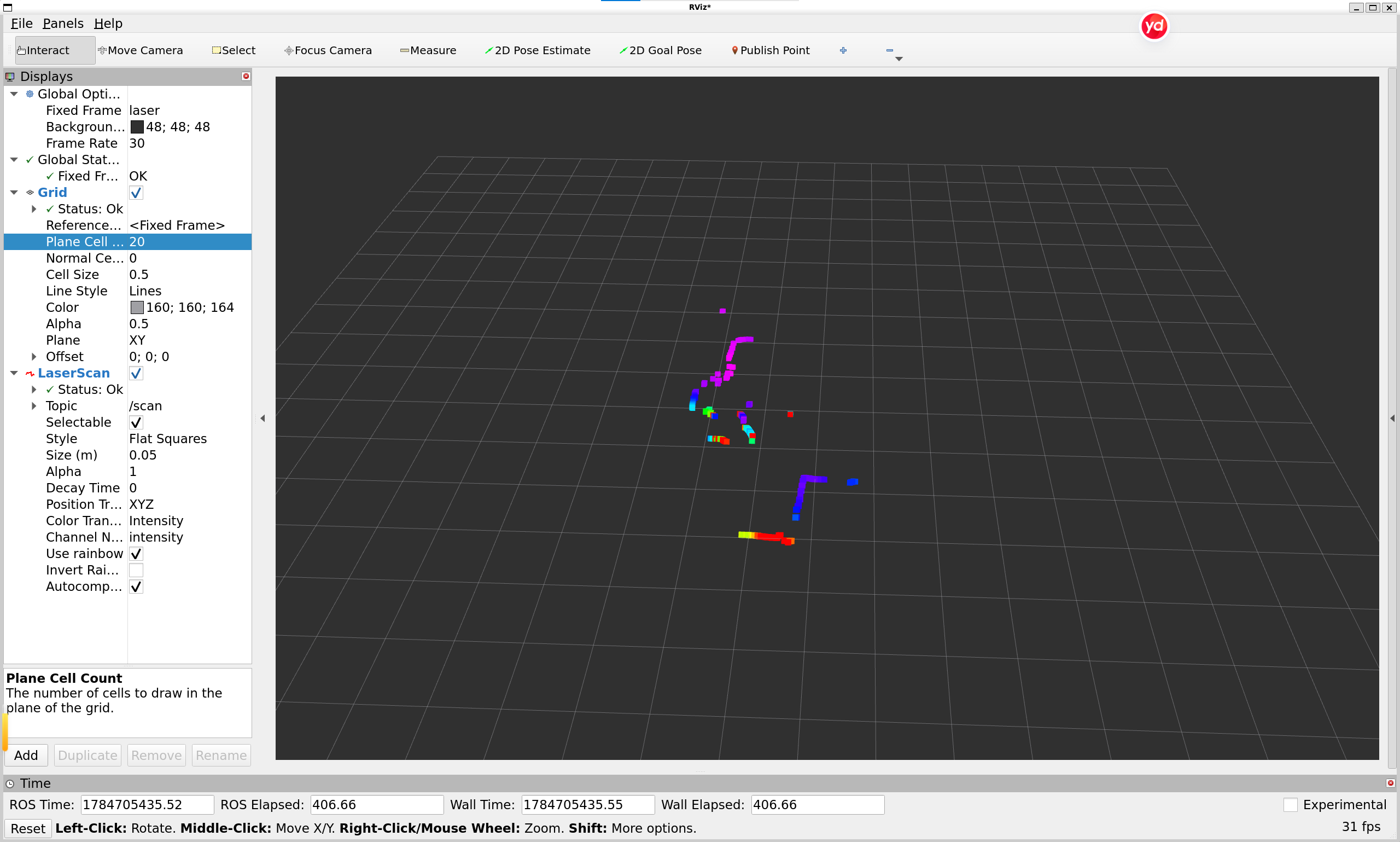
evidence/phase2.5/c1_1_ros2_rviz_laserscan.png
