terabitesyuex/ENGR1000P2_Mars-Scout-Rover/docs/phase4c_manual_test_card_zh.md

# Phase 4C 编码器与单轮电机人工测试卡

> 当前状态：`MANUAL_ACTION_REQUIRED`。本卡不构成烧录、打开串口、接通
> 电池或发送非零电机命令的授权。所有空白项必须来自实测或实物追线。

## A. 本次会话身份

- 日期/时间：
- 操作者：
- OpenRF1 板编号或照片标识：
- 拟烧录目标（只能选一项）：
  - [ ] `OpenRF1_Encoder_Bringup`（先做）
  - [ ] `OpenRF1_Motor_Bringup`（仅在编码器步骤通过后）
- 用户确认的 CH340 COM 口：
- 固件 HEX SHA-256：

## B. 断电与机械安全

- [ ] 车辆主电池已断开
- [ ] 四个车轮已架空或拆下，车体不能自行移动
- [ ] 急停/断电动作可由一人立即完成
- [ ] 工作区无人接触车轮、轴、联轴器
- [ ] CN1-CN4 插头方向和 pin 1 已拍照
- 证据照片路径/文件名：

## C. 电气预检实测

| 测量项 | 实测值 | 仪表与量程 | 判定/备注 |
| --- | ---: | --- | --- |
| 电池中心对外壳极性 |  |  |  |
| 电池端电压 (V) |  |  |  |
| OpenRF1 VIN (V) |  |  |  |
| 5 V 轨 (V) |  |  |  |
| 3.3 V 轨 (V) |  |  |  |
| CN1 A 高电平 (V) |  |  |  |
| CN1 B 高电平 (V) |  |  |  |
| CN2 A 高电平 (V) |  |  |  |
| CN2 B 高电平 (V) |  |  |  |
| CN3 A 高电平 (V) |  |  |  |
| CN3 B 高电平 (V) |  |  |  |
| CN4 A 高电平 (V) |  |  |  |
| CN4 B 高电平 (V) |  |  |  |

- [ ] 八路编码器 A/B 均确认有独立、合适的 3.3 V 上拉
- 上拉电阻实测/色环：
- 保险丝规格与安装位置：
- 电流限制方式：
- 公共地连续性结果：

任何 A/B 高电平超过 STM32 3.3 V 输入边界、极性不明、公共地不通或
上拉不明时停止，不烧录、不接入信号。

## D. 断电追线

| 连接器 | 实际车轮（FL/FR/RL/RR） | 电机线/编码器线连续性证据 |
| --- | --- | --- |
| CN1 |  |  |
| CN2 |  |  |
| CN3 |  |  |
| CN4 |  |  |

- 麦克纳姆轮滚子布局照片：
- X 布局判定：

## E. 编码器只读观察

前置条件：A-D 完成，并另行明确授权烧录
`OpenRF1_Encoder_Bringup` 和打开上述 COM 口。主电池仍断开，不发送任何
电机命令。

| 手转车轮 | 方向标记 | 变化的 CN | 起始 raw | 结束 raw | delta 符号 | 一圈计数 |
| --- | --- | --- | ---: | ---: | ---: | ---: |
|  | 方向 A |  |  |  |  |  |
|  | 方向 B |  |  |  |  |  |
|  | 方向 A |  |  |  |  |  |
|  | 方向 B |  |  |  |  |  |
|  | 方向 A |  |  |  |  |  |
|  | 方向 B |  |  |  |  |  |
|  | 方向 A |  |  |  |  |  |
|  | 方向 B |  |  |  |  |  |

- 原始 JSONL 文件：
- 严格检查报告：
- 序列丢失数：
- 结论：

若一次只转一个轮却有多个 CN 计数变化、计数不变、方向不稳定或检查器
失败，则停止并保留原始记录。

## F. 单轮有源测试参数（不得预填）

仅在 E 通过、重新评审电气安全并另行明确授权电池供电和非零命令后填写：

- 选择连接器 CN：
- 已追线的实际车轮：
- motor sign：
- encoder sign：
- 经评审的最大测试 duty（permille）：
- watchdog（ms）：
- 首次 RUN duty（必须不高于评审上限）：
- 预期方向：
- 预计最长通电时间：
- STOP 操作者与断电操作者：

## G. 单轮测试结果

- 启动前遥测为 `unconfigured` 且 output inactive：
- CONFIG 后仍无输出：
- ARM 后仍无输出：
- RUN 后只有所选车轮动作：
- 编码器仅对应 CN 变化：
- HEARTBEAT 停止后看门狗停机时间：
- STOP 停机时间：
- RESET 后 CCR/CCER/MOE 状态：
- 峰值电流 (A)：
- 异响、发热、抖动：
- 原始 JSONL/视频/照片：
- 最终结论：

任一结果与预期不符时，不测试下一只轮，不进入四轮运动。
