terabitesyuex/ENGR1000P2_Mars-Scout-Rover/docs/wiring.md

# Wiring

Electrical safety is the first project priority. Do not connect live hardware until voltage, polarity, connector orientation, and common ground are verified.

The current assembly-level source of truth is
[`openrf1_rover_wiring_plan.md`](openrf1_rover_wiring_plan.md). It includes the
four motor/encoder connectors, exact USART2/USART3 connector pins, a selected
three-HC-SR04 allocation, power distribution, level protection, and the staged
pre-power procedure. Historical phase sections below preserve the evidence
boundary that existed when each isolated bring-up was prepared.

The user subsequently reported that the complete rover was assembled from that
plan. Exterior and underside-sensor photographs plus supplied geometry are now
archived, but no controller-bay photographs, continuity checks, voltage
measurements, or integrated operation evidence were recorded, so installed
wiring remains `UNVERIFIED`. The next software agent must begin with
[`near_term_vehicle_bringup_handoff.md`](near_term_vehicle_bringup_handoff.md).

装车现场按中文施工清单
[`openrf1_rover_wiring_plan_zh.md`](openrf1_rover_wiring_plan_zh.md) 逐项接线和
验线；工程状态与依据仍以英文总计划为准。

## Confirmed RPLIDAR C1 Wire Functions

| LiDAR wire | Function | Destination rule |
| --- | --- | --- |
| Red | VCC, 5 V | Independent regulated 5 V supply |
| Yellow | LiDAR TX | Receiver UART RX |
| Green | LiDAR RX | Transmitter UART TX |
| Black | GND | Controller and supply ground |
| Fifth position | Unused | Leave unused |

These wire functions preserve the verified C1 harness profile. They do not prove that the one physical C1 is currently connected.

## Block-Level Inventory

- RPLIDAR C1M1-R2 x1 (`c1_1`).
- HC-SR04 x3.
- TCRT5000 x2.
- BH1750 x1.
- BMP280 x1.
- MPU6050 x1.
- Hall sensor module x1.
- STM32 controller board x1.
- ESP32 board x1.
- Li-ion battery pack x1: seller-documented 11.1 V, 7800 mAh, 5C, 12.6 V fully
  charged, DC 5.5 x 2.5 mm male; polarity and BMS limits remain UNVERIFIED.
- Battery charger x1: seller-documented 12.6 V/1 A, DC 5.5 x 2.5 mm female.
- Four encoded motors.
- Four mecanum wheels.

## RPLIDAR C1 Rules

- Red VCC must use a regulated 5 V supply, not ESP32 3.3 V.
- Yellow LiDAR TX goes to a verified receiver UART RX.
- Green LiDAR RX goes to a verified transmitter UART TX.
- Black GND must share common ground with the controller and supply.
- Do not connect LiDAR TX to TX or LiDAR RX to RX.
- Do not drive LiDAR RX from a USB adapter and ESP32 at the same time.
- Future second-C1 ESP32 wiring is NOT CURRENT SCOPE and remains UNVERIFIED.
- ESP32-C3 GPIO21/GPIO20 are CONFIRMED_MODULE_EVIDENCE for the proposed module-side UART pins. The OpenRF1 schematic documents H6 pin 3 as PB11/RX3 and pin 4 as PB10/TX3; the installed harness and real USART3 link remain UNVERIFIED.
- Physical USART2/USART3 operation remains UNVERIFIED.

## Power Rules

- Use a regulated 5 V supply capable of startup current margin for each connected C1.
- Preserve the verified C1 supply range of 4.8 V to 5.2 V.
- Keep specified supply ripple below 150 mV.
- Keep motor power wiring away from UART and low-level sensor wiring.
- The seller-documented pack is Li-ion, 11.1 V nominal, 7800 mAh, 5C advertised,
  12.6 V fully charged, with a DC 5.5 x 2.5 mm male barrel connector. These are
  product-page values, not measurements; barrel polarity and BMS current limits
  remain UNVERIFIED.
- The seller-documented charger is 12.6 V/1 A with a DC 5.5 x 2.5 mm female
  connector. Disconnect the battery from the rover before charging and never
  use the charger as the rover operating supply.
- Final power-distribution topology is DESIGN_LOCKED in the assembly plan;
  installed wiring and load validation remain UNVERIFIED.

## STM32 Sensor Wiring Status

- HC-SR04 Phase 3.2E CN6 pin order, PA5 TRIG, PA4 ECHO, TIM6, and external 10 kOhm / 15 kOhm ECHO divider requirement are AUTHORITATIVE_VENDOR_DOCUMENTED.
- Do not connect HC-SR04 ECHO directly to CN6 pin 4.
- Ground-sensor Phase 3.2F tracking connector order is AUTHORITATIVE_VENDOR_DOCUMENTED: pin 1: GND, pin 2: X4 / schematic PC14, pin 3: X3 / PB0, pin 4: X2 / PC5, pin 5: X1 / PC4, pin 6: VCC_5V.
- Ground-sensor Phase 3.2F active mappings are AUTHORITATIVE_VENDOR_DOCUMENTED: signal 1 / X1 / PC4, signal 2 / X2 / PC5, and signal 3 / X3 / PB0.
- The old tracking example maps X4 to PB1 while the schematic says PC14; signal 4 / X4 is unused for Phase 3.2F.
- TCRT5000 active polarity is UNVERIFIED.
- Hall active polarity is UNVERIFIED.
- Phase 3.2A BH1750 target board is OpenRF1 with STM32F103RCT6.
- OpenRF1 software I2C SCL is PB1/SCL and SDA is PC3/SDA.
- The OpenRF1 schematic includes 10 kOhm pull-ups from PB1/SCL and PC3/SDA to 3.3 V.
- The OpenRF1 2x4 I2C header duplicates PC3/SDA, PB1/SCL, GND, and 5V rows.
- The adjacent SWD connector must not be confused with the I2C header.
- Recorded Phase 3.2A manual evidence verifies BH1750 communication at configured public 7-bit address `0x23`, 500 ms telemetry, and physical light response; absolute lux calibration remains UNVERIFIED.
- BMP280 I2C address is PHYSICAL_EVIDENCE_VERIFIED at `0x76` for the isolated Phase 3.2C BMP280-only capture; shared-bus operation remains UNVERIFIED.
- MPU6050 I2C address is planned as `0x68` with AD0 -> GND for Phase 3.2D software bring-up; physical ACK, WHO_AM_I, configuration readback, and live telemetry remain UNVERIFIED.
- Final sensor mounting offsets are UNVERIFIED.

## Phase 3.2A GY-302/BH1750 Wiring

This wiring is MANUAL_EVIDENCE_VERIFIED for the recorded BH1750-only bring-up with baseline firmware. The GY-302 module has CONFIRMED_MODULE_EVIDENCE for onboard 3.3 V regulation, logic-level conversion, module-level 3-5 V supply compatibility, and I2C pull-ups on the regulated logic rail. Distinguish those module facts from the bare BH1750 IC limit.

| GY-302 pin | OpenRF1 connection |
| --- | --- |
| VCC | OpenRF1 I2C 5V |
| GND | OpenRF1 I2C GND |
| SCL | OpenRF1 PB1/SCL |
| SDA | OpenRF1 PC3/SDA |
| ADDR | OpenRF1 GND |

Power off before changing wiring. First power-on or repeat validation should be performed without motors and without additional new sensors. The recorded evidence verifies configured-address communication and controlled light response for this exact setup, but it does not prove laboratory lux calibration.

## Phase 3.2B Proposed Full-Hardware Wiring

The following is a hardware-team proposal for future validation, not verified truth.

### ESP32-C3 SuperMini

- ESP32 5V -> OpenRF1 Bluetooth UART 5V during non-USB operation.
- ESP32 GND -> OpenRF1 Bluetooth UART GND.
- ESP32 GPIO21 TX -> OpenRF1 RX3.
- ESP32 GPIO20 RX <- OpenRF1 TX3.

Software intent: STM32 USART3 communicates with ESP32. USART3 is not the debug console. USART1 remains dedicated to CH340/debug telemetry. ESP32-C3 UART logic is 3.3 V, so no STM32-to-ESP32 UART level shifter is required for the proposed link.

Mandatory power rule: external 5 V power and USB power must not be connected simultaneously on the ESP32-C3 SuperMini. Disconnect the STM32/OpenRF1 5 V feed before plugging the ESP32 into USB. A removable jumper or switch in the ESP32 5 V wire is recommended as an integration aid, not a software requirement.

### RPLIDAR C1

- C1 VCC -> OpenRF1 user UART 5V.
- C1 GND -> OpenRF1 user UART GND.
- C1 TX -> OpenRF1 RX2.
- C1 RX <- OpenRF1 TX2.

C1 transport target: 3.3 V TTL UART, 460800 baud, 8 data bits, no parity, 1 stop bit. Do not trust wire colors alone; verify signal identity from adapter-board labels or continuity testing.

### Shared Software I2C

Known board bus:

- PB1 = SCL.
- PC3 = SDA.

Proposed power and straps:

- GY-302/BH1750 VCC -> OpenRF1 5 V, ADDR -> GND, address `0x23`.
- GY-521/MPU6050 VCC -> OpenRF1 5 V, AD0 -> GND, address `0x68`; INT, XDA, and XCL remain disconnected for polling.
- BMP280-3.3 VCC -> OpenRF1 3.3 V, CSB -> 3.3 V for I2C mode, SDO -> GND, address `0x76`.

Do not tie all I2C module VCC pins together. All grounds are common, SCL is common, and SDA is common. Do not add external I2C pull-ups by default because the OpenRF1 board and modules already contain pull-ups; inspect parallel pull-up strength during physical bus testing if communication becomes unreliable.

The BMP280-3.3 module must not connect to the I2C connector 5 V pin. No external level shifter is needed when the BMP280 module and I2C pull-ups operate at 3.3 V.

## Phase 3.2C BMP280-Only Bring-Up Wiring

This is the isolated Phase 3.2C bench target, not the full Phase 3.2B shared-bus integration. Connect only the BMP280 module:

| BMP280 pin | OpenRF1 connection | Status |
| --- | --- | --- |
| VCC | 3.3 V | CONFIRMED_MODULE_EVIDENCE for BMP280-3.3 supply rule |
| GND | GND | PHYSICAL_EVIDENCE_VERIFIED for isolated capture |
| SCL | PB1 / connector B1 | CONFIRMED OpenRF1 software-I2C signal |
| SDA | PC3 / connector C3 | CONFIRMED OpenRF1 software-I2C signal |
| CSB | 3.3 V | PHYSICAL_EVIDENCE_VERIFIED I2C-mode strap for isolated capture |
| SDO | GND | PHYSICAL_EVIDENCE_VERIFIED address strap for `0x76` in isolated capture |

Committed Phase 3.2C evidence verifies ACK at `0x76`, chip ID `0x58`, calibration-register path sufficient for compensated output, `ctrl_meas = 0x27` and `config = 0x80` readback, live compensated temperature/pressure telemetry, exact 500 ms periodicity, and a stable 30-second BMP280-only capture. Absolute temperature/pressure accuracy, environmental-reference comparison, long-duration operation, and shared-I2C concurrency remain UNVERIFIED.

## Phase 3.2D MPU6050-Only Bring-Up Wiring

This is the isolated Phase 3.2D software-prepared bench target, not the full Phase 3.2B shared-bus integration. Connect only the GY-521/MPU6050 module during the future manual test:

| GY-521/MPU6050 pin | OpenRF1 connection | Status |
| --- | --- | --- |
| VCC | 5 V | CONFIRMED_MODULE_EVIDENCE for GY-521/MPU6050 module capability; PHYSICAL_VERIFICATION_REQUIRED for this setup |
| GND | GND | PLANNED; PHYSICAL_VERIFICATION_REQUIRED |
| SCL | PB1 / connector B1 | CONFIRMED OpenRF1 software-I2C signal |
| SDA | PC3 / connector C3 | CONFIRMED OpenRF1 software-I2C signal |
| AD0 | GND | PLANNED for address `0x68`; PHYSICAL_VERIFICATION_REQUIRED |
| INT | disconnected | PLANNED polling bring-up |
| XDA/XCL | disconnected | PLANNED polling bring-up |
| FSYNC | disconnected | PLANNED polling bring-up |

Phase 3.2D repository automation verifies only source structure and pure software behavior. MPU6050 ACK, WHO_AM_I `0x68`, configuration readback, live acceleration/angular-rate/temperature telemetry, calibration, axis orientation, shared-I2C concurrency, and full-hardware operation remain UNVERIFIED.

## Phase 3.2E HC-SR04-Only Bring-Up Wiring

This is the isolated Phase 3.2E software-prepared bench target, not proof of physical operation. Connect only HC-SR04 after the required checks are complete.

| HC-SR04 signal | OpenRF1 connection | Status |
| --- | --- | --- |
| VCC | CN6 pin 1: VCC_5V | AUTHORITATIVE_VENDOR_DOCUMENTED; physical power wiring UNVERIFIED |
| GND | CN6 pin 2: GND | AUTHORITATIVE_VENDOR_DOCUMENTED; physical common ground UNVERIFIED |
| TRIG | CN6 pin 3: PA5_TRIG / STM32 PA5 | AUTHORITATIVE_VENDOR_DOCUMENTED |
| ECHO | External divider output to CN6 pin 4: PA4_ECHO / STM32 PA4 | AUTHORITATIVE_VENDOR_DOCUMENTED protection requirement; physical divider installation UNVERIFIED |

Do not connect HC-SR04 ECHO directly to CN6 pin 4. Use the external divider: HC-SR04 ECHO -> 10 kOhm series resistor -> protected PA4 / CN6-pin-4 node; protected PA4 node -> 15 kOhm resistor -> GND. Use 5 percent tolerance or better. TRIG remains directly connected from PA5 to the module TRIG input according to the vendor design.

The vendor example configures PA5 as push-pull output, PA4 as floating input, and TIM6 with prescaler 71 and period 30000 for nominal 1 us timing. Actual board connector orientation, cable orientation, resistor values, ECHO voltages, trigger pulse, echo pulse, and real distance data remain UNVERIFIED.

Disconnect all power before changing wiring. Check printed module labels rather than assuming left-to-right order. Measurements are nominal and uncalibrated.

### HC-SR04 Multi-Sensor Future Allocation

Earlier Phase 3.2B logical allocation for all three HC-SR04 modules remains UNVERIFIED beyond the Phase 3.2E CN6 isolated baseline. Do not assign final front/left/right mounting or trigger multiple modules until physical integration evidence exists.

For any future non-CN6 HC-SR04 path, Echo level protection is conditional on module supply and measured Echo VOH, plus the exact STM32 input path. Direct connection is not approved without recorded voltage-safety evidence.

## Phase 3.2F Ground-Sensor-Only Bring-Up Wiring

This is the isolated Phase 3.2F bench target. The two TCRT5000 PC4/PC5 connections and live response have isolated manual evidence; the Hall path and electrical measurements do not. Connect only the modules needed for the current controlled test.

A user-supplied installed-rover photograph confirms the Hall module is mounted
on the rover underside and that the photograph's top edge is rover-forward.
The corrected Hall sensing-point clearances are 185 mm to the front body
boundary, 135 mm to the rear boundary, 75 mm to each side, and 95 mm to each
axle centre. Together with the 190 mm wheelbase, these establish x=0 mm, y=0 mm
in the wheel-centre `base_link` plane; they also derive x=-25 mm, y=0 mm from
the 320 x 150 mm body-envelope centre. The evidence does not establish connector
pin order or conductor function. The Hall sensing-point floor height is supplied
as 65 mm, deriving `base_link z=+25.5 mm` from the supplied 39.5 mm loaded wheel
radius. The evidence does not establish divider installation, sensing face, active
polarity, triggering pole, or magnetic response.

Vendor-documented tracking connector order:

- pin 1: GND.
- pin 2: X4 / schematic PC14.
- pin 3: X3 / PB0.
- pin 4: X2 / PC5.
- pin 5: X1 / PC4.
- pin 6: VCC_5V.

Do not infer connector orientation from wire colours, cable orientation, apparent left-to-right order in a photograph, or connector position alone. Verify printed labels, keying, or schematic references.

| Module signal | OpenRF1 connection | Status |
| --- | --- | --- |
| Left TCRT5000 OUT | connector signal 1 / X1 / PC4 | AUTHORITATIVE_VENDOR_DOCUMENTED mapping; isolated connection MANUAL_EVIDENCE_VERIFIED |
| Left TCRT5000 VCC | STM32 labelled 3.3 V | Connection MANUAL_EVIDENCE_VERIFIED; actual rail voltage UNVERIFIED |
| Left TCRT5000 GND | common GND | Isolated connection MANUAL_EVIDENCE_VERIFIED; continuity UNVERIFIED |
| Right TCRT5000 OUT | connector signal 2 / X2 / PC5 | AUTHORITATIVE_VENDOR_DOCUMENTED mapping; isolated connection MANUAL_EVIDENCE_VERIFIED |
| Right TCRT5000 VCC | STM32 labelled 3.3 V | Connection MANUAL_EVIDENCE_VERIFIED; actual rail voltage UNVERIFIED |
| Right TCRT5000 GND | common GND | Isolated connection MANUAL_EVIDENCE_VERIFIED; continuity UNVERIFIED |
| Hall + | 5 V | DESIGN_LOCKED module supply; actual rail UNVERIFIED |
| Hall - | common GND | PLANNED; PHYSICAL_VERIFICATION_REQUIRED |
| Hall S | external 10 kOhm / 15 kOhm divider -> connector signal 3 / X3 / PB0 | DESIGN_LOCKED protection requirement; physical divider installation UNVERIFIED |

Do not power the TCRT modules from the connector's 5 V pin during controlled bring-up. Do not share one VCC rail across all three modules. Do not connect Hall S directly to PB0.

Use the external Hall divider: Hall S -> 10 kOhm series resistor -> protected PB0 node; protected PB0 node -> 15 kOhm resistor -> GND. Use 5 percent tolerance or better. Nominal behavior is 5.0 V -> approximately 3.0 V and 5.5 V -> approximately 3.3 V at PB0.

The old tracking example maps X4 to PB1 while the schematic says PC14. Signal 4 / X4 is unused in Phase 3.2F and must not be initialized, read, or emitted in telemetry.

The firmware configures PC4, PC5, and PB0 as floating input, samples every 5 ms, applies 4-sample independent debounce, and emits 50 ms JSONL raw/debounced numeric levels. Raw GPIO values are not semantic detection states, and semantic polarity remains unverified.

The isolated PC4/PC5 TCRT channels produced live transitions and four gap-free 100-frame captures with exact 50 ms steady-state timestamps. Final connector/cable orientation, measured voltages, TCRT output topology, active polarity, black/white/drop classification, Hall voltages/polarity, magnetic behavior, long-duration debounce suitability, and full-hardware operation remain UNVERIFIED.

## Future Verification Checklist

- Verify supply voltage and polarity before attaching each module.
- Verify common ground.
- Verify connector orientation.
- Verify current margin under motor load.
- Verify the one `c1_1` unit before any future inventory expansion; dual-C1 wiring is NOT CURRENT SCOPE.
- Verify STM32-ESP32 physical link before relying on transferred sensor data.
- Label each neutral sensor ID after installation evidence exists.
