terabitesyuex/ENGR1000P2_Mars-Scout-Rover/evidence/hardware/vehicle_assembly_2026-07-23/missing_information_responses.docx

顺序 | 信息 | 具体形式 | 获取方式 | 用途
1 | 全车装配照片 | 顶视、前视、底盘、OpenRF1接线区各1张；顶视标注车头 | 断电拍照 | 核对轮位、麦轮方向和线束
2 | 四轮接口对应 | CN1=__，CN2=__，CN3=__，CN4=__，填左前/右前/左后/右后 | 沿线追踪 | 锁定电机与编码器逻辑ID
| | 从后方看，左上对左前，右上右前，左下左后，右下右后，ID不清楚
3 | 麦轮滚子方向 | 一张清楚顶视图，四个轮子完整可见 | 断电拍照 | 确认X型麦克纳姆布局
4 | 电池与电源测量 | 电池中心/外壳极性；电池电压、OpenRF1 VIN、降压输出、板载5V和3.3V，单位V | 万用表 | 首次上电安全门
5 | 主电源保护 | BMS连续/峰值电流、保险丝规格、主电源线线径或AWG | 标签、商品资料或线材印字 | 判断堵转和短路保护能力
6 | 底盘几何 | 负载轮直径、前后轮轴中心距、左右轮中心距，单位mm | 车放地面测量 | 麦轮运动学和里程计
| | 79、190、217
7 | 编码器确认 | 轮子转1圈时四路计数；先暂用名义1320 counts/rev | 后续测试固件测量 | 确认减速比和计数倍率
8 | 电机/编码器方向 | 每轮正PWM的实际转向、手动向前转时计数增减 | 架空轮测试 | 得到8个方向符号
9 | 运动目标 | 最大速度m/s、最大转速deg/s、期望停车距离mm | 你们确定 | 设置速度、加速度和安全上限
10 | 三个超声安装 | 每个传感器相对车体中心的x/y/z mm及朝向角deg | 测量 | 避障距离和方向判断
| | 左到右(-45度，0度，45度)：(-42.45,2.67,132.23）, (0, 2.67, 148.33), (41.18,2.67,132.23)
11 | TCRT与Hall安装 | TCRT离地高度、前后左右位置；Hall位置和磁铁工作距离，单位mm | 测量 | 阈值、去抖和安全逻辑
12 | MPU6050方向 | 模块顶视照片，并标出车头方向 | 拍照 | 确定X/Y/Z轴和偏航符号
13 | C1安装位姿 | 相对车体中心x/y/z mm、0°扫描方向、安装高度 | 测量和照片 | 雷达坐标转换
14 | ESP32开发选择 | Arduino、PlatformIO或ESP-IDF；不知道可写“由你决定” | 直接回答 | 建立ESP32-C3 WiFi工程
15 | PC控制方式 | 键盘、手柄或网页；PC系统版本 | 直接回答 | 确定遥控和调试界面
16 | 硬件调试授权 | 是否允许我指导打开串口、烧录和架空轮测试 | 明确文字批准 | 才能进入Phase 4C
