terabitesyuex/ENGR1000P2_Mars-Scout-Rover/evidence/hardware/vehicle_assembly_2026-07-23/cad_mount_offsets_view1.jpg

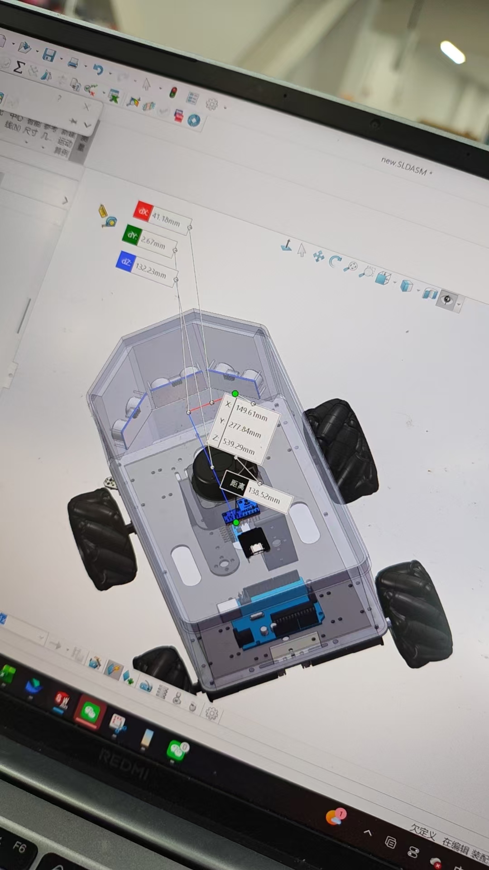
evidence/hardware/vehicle_assembly_2026-07-23/cad_mount_offsets_view1.jpg
