terabitesyuex/ENGR1000P2_Mars-Scout-Rover/evidence/hardware/vehicle_assembly_2026-07-23/mpu6050_top_axis.jpg

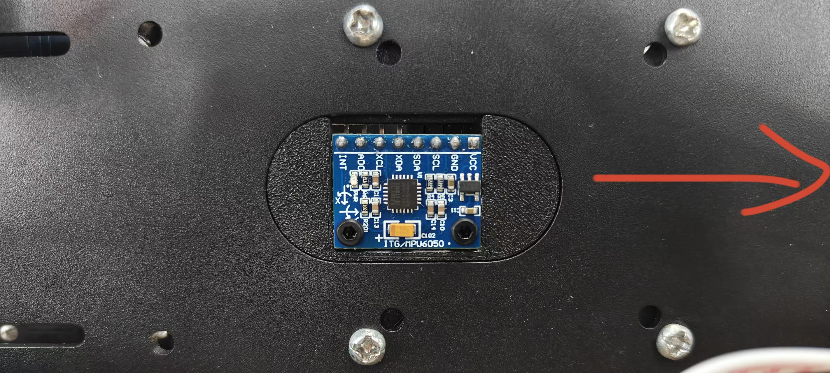
evidence/hardware/vehicle_assembly_2026-07-23/mpu6050_top_axis.jpg
