terabitesyuex/ENGR1000P2_Mars-Scout-Rover/evidence/hardware/vehicle_assembly_2026-07-23/vehicle_top_front_marked.jpg

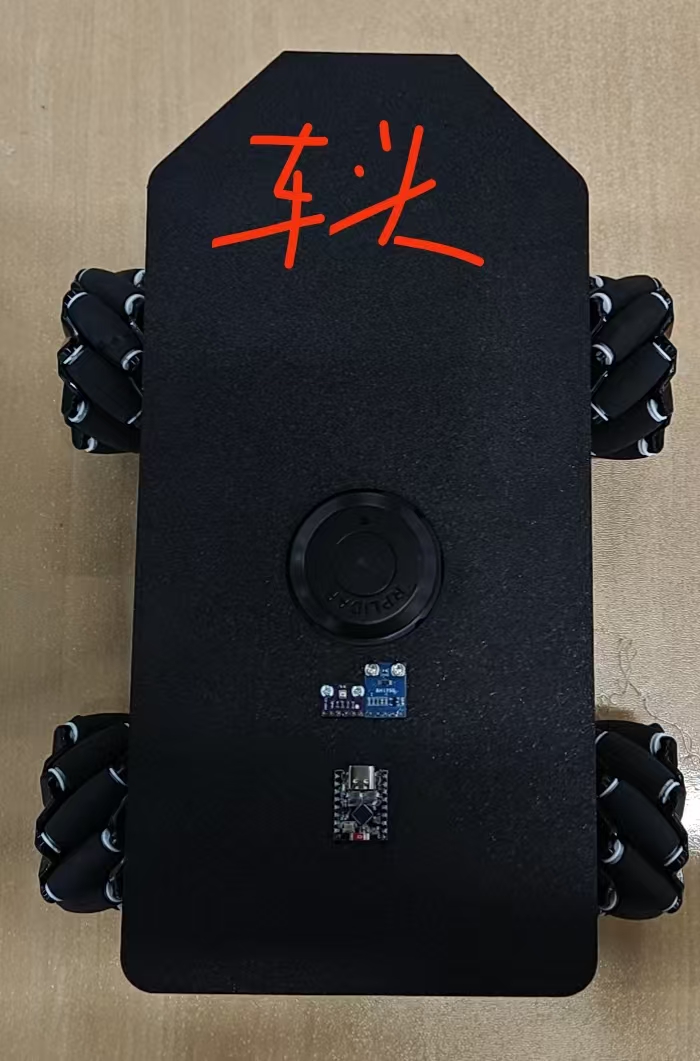
evidence/hardware/vehicle_assembly_2026-07-23/vehicle_top_front_marked.jpg
