terabitesyuex/ENGR1000P2_Mars-Scout-Rover/docs/calibration.md

# Calibration Plan

No physical calibration is completed by Phase 3.1 automation. This file records future calibration responsibilities only.

## RPLIDAR C1

- Calibrate the one physical `c1_1` after acceptance evidence exists.
- Use Phase 2.5 PC-direct captures as input evidence only after the manual hardware procedure is actually run.
- Confirm forward direction relative to rover chassis.
- Confirm native zero-angle direction.
- Record mounting height, position, yaw, and orientation.
- Confirm range bias against known distances.
- Confirm angular orientation using known wall geometry.
- Measure scan rate and dropped/corrupt scan rate.

## HC-SR04

- For Phase 3.2E, do not connect HC-SR04 ECHO directly to CN6 pin 4. Install and verify the external 10 kOhm / 15 kOhm divider before PA4 receives the signal, then record Echo voltage before and after division.
- Measure distance error for each of `ultrasonic_1`, `ultrasonic_2`, and `ultrasonic_3`.
- Measure timeout behavior.
- Measure cross-talk rate.
- Relate measured ranges to stop-distance contribution.
- Verify logic-level interface before wiring to the physical controller.

## TCRT5000

- Preserve raw digital state during polarity verification.
- Calibrate `tcrt5000_1` and `tcrt5000_2` for edge/drop detection.
- Measure false positives.
- Check installation-height sensitivity.
- Verify active polarity before relying on safety decisions.

## Hall Sensor

- Preserve raw digital state during polarity verification.
- Calibrate `hall_1` for magnetic landmark/checkpoint detection.
- Measure repeatability and false positives.
- Do not use the Hall module as wheel odometry.
- Verify active polarity before hardware integration.

## BH1750

- Calibrate `bh1750_1` illuminance response in lux.
- Measure repeatability.
- Test response to controlled light changes.
- Do not claim reliable real-world dust-storm detection.
- Phase 3.2A configures GY-302/BH1750 on OpenRF1 software I2C PB1/PC3 with ADDR grounded for public 7-bit address `0x23`; recorded manual evidence verifies configured-address communication, 500 ms telemetry, and physical cover/illumination response.
- Absolute lux calibration remains UNVERIFIED until a calibrated reference procedure is performed.
- Treat a valid zero-lux reading as darkness only after a successful sensor transaction; communication failures must remain explicit error statuses with no substituted zero.
- Record commit, date, operator, wiring revision, private COM-port identifier, expected result, observed result, pass/fail, and evidence paths.

## BMP280

- Calibrate `bmp280_1` temperature and atmospheric-pressure readings.
- Measure temperature stability.
- Measure pressure stability.
- Test response to controlled environmental changes where practical.

## Encoders And Mecanum Geometry

- Measure encoder counts per wheel revolution.
- Recheck the supplied 79 mm loaded wheel diameter and record tolerance.
- Recheck the supplied 190 mm wheelbase and 217 mm track width.
- Preserve 39.5 mm wheel radius and 108.5 mm half-track without integer
  rounding in production configuration.
- Verify forward, lateral, and yaw kinematics.
- Measure straight-distance, lateral-distance, yaw, and repeatability errors.

## MPU6050

- Phase 3.2D only prepares isolated bring-up software; it does not calibrate the sensor.
- Verify ACK, WHO_AM_I, configuration readback, and live telemetry before any calibration work.
- Measure gyro bias.
- Measure accelerometer offsets.
- Confirm axis orientation relative to the rover.
- Use the archived top/underside orientation photographs as the mounting record,
  then verify the transform with controlled axis motion.
- Measure yaw drift over short intervals.

## WiFi Timing

- Measure packet loss.
- Measure latency.
- Measure reconnection behavior.
- Confirm timeout stop behavior is independent of PC visualization.

## Accumulated Map Dimensions

- Use known-dimension test areas.
- Measure point-cloud distortion.
- Measure trajectory drift.
- Record map-scale and frame-assignment assumptions.

Calibration changes must be recorded in `CHANGELOG.md` only after measurements are performed.
