terabitesyuex/ENGR1000P2_Mars-Scout-Rover/firmware/openrf1/full_hardware/board_config.h

#pragma once

#include <stdint.h>
#include "stm32f10x.h"

#define OPENRF1_FULL_BOARD_NAME "OpenRF1"
#define OPENRF1_FULL_PHASE "phase3.2b"
#define OPENRF1_FULL_MCU_PART "STM32F103RCT6"
#define OPENRF1_FULL_FLASH_BYTES ((uint32_t)262144u)
#define OPENRF1_FULL_SRAM_BYTES ((uint32_t)49152u)

#define OPENRF1_ENABLE_BH1750 1
#define OPENRF1_ENABLE_BMP280 1
#define OPENRF1_ENABLE_MPU6050 1
#define OPENRF1_ENABLE_ULTRASONIC 1
#define OPENRF1_ENABLE_GROUND_SENSORS 1
#define OPENRF1_ENABLE_HALL 1
#define OPENRF1_ENABLE_RPLIDAR_C1 1
#define OPENRF1_ENABLE_ESP32_LINK 1

/*
 * CONFIRMED from Phase 3.2A evidence: OpenRF1 software I2C uses PB1/SCL
 * and PC3/SDA with board pull-ups to 3.3 V. Recorded manual evidence verifies
 * BH1750 communication at 0x23; BMP280 and MPU6050 ACKs remain UNVERIFIED.
 */
#define OPENRF1_I2C_SCL_PORT GPIOB
#define OPENRF1_I2C_SCL_PIN GPIO_Pin_1
#define OPENRF1_I2C_SCL_RCC RCC_APB2Periph_GPIOB
#define OPENRF1_I2C_SDA_PORT GPIOC
#define OPENRF1_I2C_SDA_PIN GPIO_Pin_3
#define OPENRF1_I2C_SDA_RCC RCC_APB2Periph_GPIOC

#define OPENRF1_BH1750_SENSOR_ID "bh1750_1"
#define OPENRF1_BH1750_ADDRESS_7BIT ((uint8_t)0x23u)
#define OPENRF1_BMP280_SENSOR_ID "bmp280_1"
#define OPENRF1_BMP280_ADDRESS_7BIT_PROVISIONAL ((uint8_t)0x76u)
#define OPENRF1_MPU6050_SENSOR_ID "mpu6050_1"
#define OPENRF1_MPU6050_ADDRESS_7BIT_PROVISIONAL ((uint8_t)0x68u)

#define OPENRF1_DEBUG_USART USART1
#define OPENRF1_DEBUG_USART_RCC RCC_APB2Periph_USART1
#define OPENRF1_DEBUG_TX_PORT GPIOA
#define OPENRF1_DEBUG_TX_PIN GPIO_Pin_9
#define OPENRF1_DEBUG_RX_PORT GPIOA
#define OPENRF1_DEBUG_RX_PIN GPIO_Pin_10
#define OPENRF1_DEBUG_GPIO_RCC RCC_APB2Periph_GPIOA
#define OPENRF1_DEBUG_BAUD ((uint32_t)115200u)
#define OPENRF1_DEBUG_TX_SPIN_LIMIT ((uint16_t)2000u)

/*
 * The connector proposal names USART2 as the RPLIDAR C1 link and USART3 as
 * the ESP32-C3 link. Actual OpenRF1 connector-to-MCU pin evidence is
 * UNVERIFIED, so hardware pin initialization remains isolated from the pure
 * transport buffers in this software foundation.
 */
#define OPENRF1_RPLIDAR_USART_NAME "USART2"
#define OPENRF1_RPLIDAR_BAUD ((uint32_t)460800u)
#define OPENRF1_RPLIDAR_USART_PINS_CONFIRMED 0
#define OPENRF1_RPLIDAR_RX_BUFFER_BYTES ((uint16_t)2048u)
#define OPENRF1_RPLIDAR_CHUNK_BYTES ((uint16_t)64u)

#define OPENRF1_ESP32_USART_NAME "USART3"
#define OPENRF1_ESP32_BAUD_PROVISIONAL ((uint32_t)921600u)
#define OPENRF1_ESP32_USART_PINS_CONFIRMED 0
#define OPENRF1_ESP32_RX_BUFFER_BYTES ((uint16_t)512u)
#define OPENRF1_ESP32_TX_BUFFER_BYTES ((uint16_t)512u)
#define OPENRF1_ESP32_MAX_PAYLOAD_BYTES ((uint16_t)256u)

#define OPENRF1_TELEMETRY_BUFFER_BYTES ((uint16_t)320u)

#define OPENRF1_TASK_GROUND_HALL_PERIOD_MS ((uint32_t)10u)
#define OPENRF1_TASK_MPU6050_PERIOD_MS ((uint32_t)10u)
#define OPENRF1_TASK_BMP280_PERIOD_MS ((uint32_t)100u)
#define OPENRF1_TASK_BH1750_PERIOD_MS ((uint32_t)500u)
#define OPENRF1_TASK_ULTRASONIC_PERIOD_MS ((uint32_t)2u)
#define OPENRF1_TASK_STATUS_PERIOD_MS ((uint32_t)1000u)

#define OPENRF1_HCSR04_SENSOR_COUNT ((uint8_t)3u)
#define OPENRF1_HCSR04_TRIGGER_US ((uint16_t)10u)
#define OPENRF1_HCSR04_TIMEOUT_US ((uint32_t)30000u)
#define OPENRF1_HCSR04_QUIET_TIME_US ((uint32_t)5000u)

#define OPENRF1_DIGITAL_FILTER_STABLE_SAMPLES ((uint8_t)3u)
#define OPENRF1_SOFT_I2C_RECOVERY_PULSES ((uint8_t)9u)

#define OPENRF1_STATIC_ASSERT(name, condition) typedef char name[(condition) ? 1 : -1]
