terabitesyuex/ENGR1000P2_Mars-Scout-Rover/firmware/openrf1/hcsr04_bringup/board_config.h

#pragma once

#include <stdint.h>
#include "stm32f10x.h"

#define OPENRF1_HCSR04_BRINGUP_PHASE "phase3.2e"
#define OPENRF1_HCSR04_BOARD_NAME "OpenRF1"
#define OPENRF1_HCSR04_MCU_PART "STM32F103RCT6"

#define OPENRF1_HCSR04_SENSOR_ID "ultrasonic_1"
#define OPENRF1_HCSR04_SENSOR_NAME "hc-sr04"
#define OPENRF1_HCSR04_CONNECTOR "CN6"
#define OPENRF1_HCSR04_CONNECTOR_PART "B4B-PH-K-S(LF)(SN)"
#define OPENRF1_HCSR04_CONNECTOR_PIN1 "VCC_5V"
#define OPENRF1_HCSR04_CONNECTOR_PIN2 "GND"
#define OPENRF1_HCSR04_CONNECTOR_PIN3 "PA5_TRIG"
#define OPENRF1_HCSR04_CONNECTOR_PIN4 "PA4_ECHO"

#define OPENRF1_HCSR04_TRIGGER_PORT GPIOA
#define OPENRF1_HCSR04_TRIGGER_PIN GPIO_Pin_5
#define OPENRF1_HCSR04_TRIGGER_RCC RCC_APB2Periph_GPIOA
#define OPENRF1_HCSR04_TRIGGER_PIN_TEXT "PA5"

#define OPENRF1_HCSR04_ECHO_PORT GPIOA
#define OPENRF1_HCSR04_ECHO_PIN GPIO_Pin_4
#define OPENRF1_HCSR04_ECHO_RCC RCC_APB2Periph_GPIOA
#define OPENRF1_HCSR04_ECHO_PIN_TEXT "PA4"

#define OPENRF1_HCSR04_TIMER TIM6
#define OPENRF1_HCSR04_TIMER_RCC RCC_APB1Periph_TIM6
#define OPENRF1_HCSR04_TIMER_TEXT "TIM6"
#define OPENRF1_HCSR04_TIMER_PRESCALER ((uint16_t)71u)
#define OPENRF1_HCSR04_TIMER_PERIOD ((uint16_t)30000u)
#define OPENRF1_HCSR04_TIMER_MODULUS_US ((uint32_t)30001u)
#define OPENRF1_HCSR04_TIMER_TICK_HZ ((uint32_t)1000000u)

#define OPENRF1_HCSR04_DEBUG_USART USART1
#define OPENRF1_HCSR04_DEBUG_USART_RCC RCC_APB2Periph_USART1
#define OPENRF1_HCSR04_DEBUG_TX_PORT GPIOA
#define OPENRF1_HCSR04_DEBUG_TX_PIN GPIO_Pin_9
#define OPENRF1_HCSR04_DEBUG_RX_PORT GPIOA
#define OPENRF1_HCSR04_DEBUG_RX_PIN GPIO_Pin_10
#define OPENRF1_HCSR04_DEBUG_GPIO_RCC RCC_APB2Periph_GPIOA
#define OPENRF1_HCSR04_DEBUG_BAUD ((uint32_t)115200u)
#define OPENRF1_HCSR04_DEBUG_TX_SPIN_LIMIT ((uint16_t)2000u)

#define OPENRF1_HCSR04_TRIGGER_PULSE_US ((uint16_t)10u)
#define OPENRF1_HCSR04_ECHO_TIMEOUT_US ((uint32_t)30000u)
#define OPENRF1_HCSR04_MEASUREMENT_PERIOD_MS ((uint32_t)100u)
#define OPENRF1_HCSR04_WAIT_POLL_LIMIT ((uint32_t)1200000u)
#define OPENRF1_HCSR04_TELEMETRY_MAX_LINE_BYTES ((uint16_t)512u)
#define OPENRF1_HCSR04_TELEMETRY_BUFFER_BYTES ((uint16_t)513u)

#define OPENRF1_HCSR04_ECHO_SERIES_RESISTOR_OHM ((uint16_t)10000u)
#define OPENRF1_HCSR04_ECHO_PULLDOWN_RESISTOR_OHM ((uint16_t)15000u)
#define OPENRF1_HCSR04_ECHO_DIVIDER_TOLERANCE_PERCENT ((uint8_t)5u)
#define OPENRF1_HCSR04_DISTANCE_MODEL "nominal_343_m_per_s_uncalibrated"
