terabitesyuex/ENGR1000P2_Mars-Scout-Rover/firmware/openrf1/mpu6050_bringup/board_config.h

#pragma once

#include <stdint.h>
#include "stm32f10x.h"

#define OPENRF1_MPU6050_BRINGUP_PHASE "phase3.2d"
#define OPENRF1_MPU6050_BOARD_NAME "OpenRF1"
#define OPENRF1_MPU6050_MCU_PART "STM32F103RCT6"

#define OPENRF1_MPU6050_SENSOR_ID "mpu6050_1"
#define OPENRF1_MPU6050_ADDRESS_7BIT ((uint8_t)0x68u)

#define OPENRF1_SOFT_I2C_SCL_PORT GPIOB
#define OPENRF1_SOFT_I2C_SCL_PIN GPIO_Pin_1
#define OPENRF1_SOFT_I2C_SCL_RCC RCC_APB2Periph_GPIOB

#define OPENRF1_SOFT_I2C_SDA_PORT GPIOC
#define OPENRF1_SOFT_I2C_SDA_PIN GPIO_Pin_3
#define OPENRF1_SOFT_I2C_SDA_RCC RCC_APB2Periph_GPIOC

#define OPENRF1_MPU6050_DEBUG_USART USART1
#define OPENRF1_MPU6050_DEBUG_USART_RCC RCC_APB2Periph_USART1
#define OPENRF1_MPU6050_DEBUG_TX_PORT GPIOA
#define OPENRF1_MPU6050_DEBUG_TX_PIN GPIO_Pin_9
#define OPENRF1_MPU6050_DEBUG_RX_PORT GPIOA
#define OPENRF1_MPU6050_DEBUG_RX_PIN GPIO_Pin_10
#define OPENRF1_MPU6050_DEBUG_GPIO_RCC RCC_APB2Periph_GPIOA
#define OPENRF1_MPU6050_DEBUG_BAUD ((uint32_t)115200u)
#define OPENRF1_MPU6050_DEBUG_TX_SPIN_LIMIT ((uint16_t)2000u)

#define OPENRF1_MPU6050_SAMPLE_PERIOD_MS ((uint32_t)100u)
#define OPENRF1_MPU6050_TELEMETRY_BUFFER_BYTES ((uint16_t)768u)
#define OPENRF1_MPU6050_WAKE_SETTLE_MS ((uint32_t)100u)

#define OPENRF1_SOFT_I2C_ACK_TIMEOUT_TICKS ((uint16_t)200u)
#define OPENRF1_SOFT_I2C_RECOVERY_PULSES ((uint8_t)9u)
