terabitesyuex/ENGR1000P2_Mars-Scout-Rover/firmware/openrf1/bmp280_bringup/board_config.h

#pragma once

#include <stdint.h>
#include "stm32f10x.h"

#define OPENRF1_BMP280_BRINGUP_PHASE "phase3.2c"
#define OPENRF1_BMP280_BOARD_NAME "OpenRF1"
#define OPENRF1_BMP280_MCU_PART "STM32F103RCT6"

#define OPENRF1_BMP280_SENSOR_ID "bmp280_1"
#define OPENRF1_BMP280_ADDRESS_7BIT ((uint8_t)0x76u)

#define OPENRF1_SOFT_I2C_SCL_PORT GPIOB
#define OPENRF1_SOFT_I2C_SCL_PIN GPIO_Pin_1
#define OPENRF1_SOFT_I2C_SCL_RCC RCC_APB2Periph_GPIOB

#define OPENRF1_SOFT_I2C_SDA_PORT GPIOC
#define OPENRF1_SOFT_I2C_SDA_PIN GPIO_Pin_3
#define OPENRF1_SOFT_I2C_SDA_RCC RCC_APB2Periph_GPIOC

#define OPENRF1_BMP280_DEBUG_USART USART1
#define OPENRF1_BMP280_DEBUG_USART_RCC RCC_APB2Periph_USART1
#define OPENRF1_BMP280_DEBUG_TX_PORT GPIOA
#define OPENRF1_BMP280_DEBUG_TX_PIN GPIO_Pin_9
#define OPENRF1_BMP280_DEBUG_RX_PORT GPIOA
#define OPENRF1_BMP280_DEBUG_RX_PIN GPIO_Pin_10
#define OPENRF1_BMP280_DEBUG_GPIO_RCC RCC_APB2Periph_GPIOA
#define OPENRF1_BMP280_DEBUG_BAUD ((uint32_t)115200u)
#define OPENRF1_BMP280_DEBUG_TX_SPIN_LIMIT ((uint16_t)2000u)

#define OPENRF1_BMP280_SAMPLE_PERIOD_MS ((uint32_t)500u)
#define OPENRF1_BMP280_TELEMETRY_BUFFER_BYTES ((uint16_t)384u)

#define OPENRF1_SOFT_I2C_ACK_TIMEOUT_TICKS ((uint16_t)200u)
#define OPENRF1_SOFT_I2C_RECOVERY_PULSES ((uint8_t)9u)
