terabitesyuex/ENGR1000P2_Mars-Scout-Rover/firmware/include/build_options.h

#pragma once

namespace mars_rover::lidar::build_options {

constexpr bool kEnableCsvDebugOutput = false;
constexpr bool kEnableSyntheticFirmwareInput = false;
constexpr bool kEnableVerboseDiagnostics = false;

}  // namespace mars_rover::lidar::build_options
