terabitesyuex/ENGR1000P2_Mars-Scout-Rover/tools/validate_hardware_lock.py

"""Validate Phase 1 hardware-lock and documentation consistency.

The validator uses only the Python standard library and does not open serial
ports or communicate with LiDAR hardware.
"""

from __future__ import annotations

from collections.abc import Mapping
from dataclasses import dataclass
from pathlib import Path
import sys


SUBSYSTEM_ROOT = Path(__file__).resolve().parents[1]


@dataclass(frozen=True, slots=True)
class RequiredText:
    relative_path: str
    text: str
    description: str


REQUIRED_TEXTS: tuple[RequiredText, ...] = (
    RequiredText("HARDWARE_LOCK.md", "RPLIDAR C1M1-R2", "exact LiDAR model"),
    RequiredText("HARDWARE_LOCK.md", "XH2.54-5P", "connector type"),
    RequiredText("HARDWARE_LOCK.md", "Red | VCC", "red wire VCC function"),
    RequiredText("HARDWARE_LOCK.md", "Yellow | LiDAR TX", "yellow wire TX function"),
    RequiredText("HARDWARE_LOCK.md", "Green | LiDAR RX", "green wire RX function"),
    RequiredText("HARDWARE_LOCK.md", "Black | GND", "black wire ground function"),
    RequiredText("HARDWARE_LOCK.md", "4.8 V to 5.2 V", "supply voltage range"),
    RequiredText("HARDWARE_LOCK.md", "5.0 V", "nominal supply voltage"),
    RequiredText("HARDWARE_LOCK.md", "800 mA", "startup current"),
    RequiredText("HARDWARE_LOCK.md", "230 mA", "typical operating current"),
    RequiredText("HARDWARE_LOCK.md", "260 mA", "maximum operating current"),
    RequiredText("HARDWARE_LOCK.md", "150 mV", "supply ripple limit"),
    RequiredText("HARDWARE_LOCK.md", "3.3 V TTL", "UART voltage"),
    RequiredText("HARDWARE_LOCK.md", "460800", "UART baud rate"),
    RequiredText("HARDWARE_LOCK.md", "8 data bits, no parity, 1 stop bit", "UART format"),
    RequiredText("HARDWARE_LOCK.md", "exact ESP32 module UART GPIOs: CONFIRMED_MODULE_EVIDENCE", "ESP32 module GPIO evidence"),
    RequiredText(
        "HARDWARE_LOCK.md",
        "USART2 user-UART MCU pins: AUTHORITATIVE_VENDOR_DOCUMENTED as PA2/TX2 and PA3/RX2",
        "documented OpenRF1 USART2 assignment",
    ),
    RequiredText(
        "HARDWARE_LOCK.md",
        "USART3 Bluetooth-UART MCU pins: AUTHORITATIVE_VENDOR_DOCUMENTED as PB10/TX3 and PB11/RX3",
        "documented OpenRF1 USART3 assignment",
    ),
    RequiredText(
        "HARDWARE_LOCK.md",
        "physical operation remains UNVERIFIED",
        "unverified OpenRF1 UART physical operation",
    ),
    RequiredText("HARDWARE_LOCK.md", "External motor PWM conductor: VERIFIED not present", "motor PWM absence"),
    RequiredText("HARDWARE_LOCK.md", "RPLIDAR C1M1-R2 x1", "single C1 inventory"),
    RequiredText("HARDWARE_LOCK.md", "BH1750 x1", "BH1750 inventory"),
    RequiredText("HARDWARE_LOCK.md", "BMP280 x1", "BMP280 inventory"),
    RequiredText(
        "HARDWARE_LOCK.md",
        "Battery/power system: SELLER_DOCUMENTED Li-ion battery advertised as 11.1 V",
        "seller-documented battery baseline",
    ),
    RequiredText(
        "HARDWARE_LOCK.md",
        "39 A is not a confirmed BMS continuous/peak rating",
        "battery advertised-rate safety boundary",
    ),
    RequiredText(
        "evidence/hardware/battery/battery_evidence.md",
        "907E21846D85E6D0B023D40B91DEEF6E9BC1DE6B1251C1810CE1E0AD6E1F0637",
        "battery seller-evidence hash",
    ),
    RequiredText(
        "docs/openrf1_rover_wiring_plan.md",
        "Disconnect the battery from the rover before charging",
        "battery-detached charging rule",
    ),
    RequiredText(
        "docs/openrf1_rover_wiring_plan.md",
        "DC 5.5 x 2.5 mm male barrel",
        "battery connector size",
    ),
    RequiredText(
        "docs/openrf1_rover_wiring_plan_zh.md",
        "CN2 | PC7 / PA11 | PA6、PA7 / TIM3",
        "Chinese assembly front-left motor mapping",
    ),
    RequiredText(
        "docs/openrf1_rover_wiring_plan_zh.md",
        "H5-4 PA3/RX2",
        "Chinese assembly C1 receive mapping",
    ),
    RequiredText(
        "docs/openrf1_rover_wiring_plan_zh.md",
        "禁止未知极性直接插电池",
        "Chinese assembly battery stop rule",
    ),
    RequiredText("HARDWARE_LOCK.md", "USER-CONFIRMED PLANNED CONNECTION", "planned STM32 ground connector status"),
    RequiredText("HARDWARE_LOCK.md", "HC-SR04 ECHO voltage compatibility", "HC-SR04 ECHO status"),
    RequiredText("HARDWARE_LOCK.md", "TCRT5000 and Hall output polarity remains UNVERIFIED", "digital polarity status"),
    RequiredText("HARDWARE_LOCK.md", "OpenRF1 robot controller", "OpenRF1 board identity"),
    RequiredText("HARDWARE_LOCK.md", "STM32F103RCT6", "OpenRF1 MCU identity"),
    RequiredText("HARDWARE_LOCK.md", "PB1", "OpenRF1 software I2C SCL"),
    RequiredText("HARDWARE_LOCK.md", "PC3", "OpenRF1 software I2C SDA"),
    RequiredText("HARDWARE_LOCK.md", "0x23", "BH1750 address plan"),
    RequiredText("HARDWARE_LOCK.md", "BH1750 communication at configured address `0x23`", "BH1750 manual evidence status"),
    RequiredText("firmware/openrf1/app/board_config.h", "OPENRF1_MCU_PART \"STM32F103RCT6\"", "OpenRF1 firmware MCU lock"),
    RequiredText("firmware/openrf1/app/board_config.h", "OPENRF1_SOFT_I2C_SCL_PORT GPIOB", "OpenRF1 firmware SCL port"),
    RequiredText("firmware/openrf1/app/board_config.h", "OPENRF1_SOFT_I2C_SDA_PORT GPIOC", "OpenRF1 firmware SDA port"),
    RequiredText("firmware/openrf1/app/board_config.h", "OPENRF1_BH1750_ADDRESS_7BIT ((uint8_t)0x23u)", "OpenRF1 firmware BH1750 address"),
    RequiredText("HARDWARE_LOCK.md", "Physical wiring verification date: UNVERIFIED", "unverified wiring date"),
    RequiredText("HARDWARE_LOCK.md", "C1 serial ID: UNVERIFIED", "unverified serial status"),
    RequiredText("docs/phase1_hardware_audit.md", "Documentation Conflicts", "conflict log"),
    RequiredText("docs/phase1_hardware_audit.md", "UNVERIFIED Values", "unverified value log"),
    RequiredText("docs/phase1_interface_inventory.md", "LidarInterface", "firmware interface inventory"),
    RequiredText("docs/phase1_interface_inventory.md", "ScanSource", "PC scan-source interface inventory"),
    RequiredText("firmware/include/hardware_profile.h", "kLidarBaudRate = 460800", "firmware baud lock"),
    RequiredText("firmware/include/hardware_profile.h", "kLidarSerialConfig = SERIAL_8N1", "firmware UART format"),
    RequiredText("firmware/include/hardware_profile.h", "#ifndef RPLIDAR_C1_LIDAR_RX_PIN", "RX compile-time guard"),
    RequiredText("firmware/include/hardware_profile.h", "#ifndef RPLIDAR_C1_LIDAR_TX_PIN", "TX compile-time guard"),
    RequiredText("firmware/include/hardware_profile.h", "kHasExternalMotorPwm = false", "no external motor PWM"),
    RequiredText(
        "docs/openrf1_rover_wiring_plan.md",
        "H5 | USART2 user port | 1 5V, 2 GND, 3 PA2/TX2, 4 PA3/RX2",
        "assembly USART2 connector pinout",
    ),
    RequiredText(
        "docs/openrf1_rover_wiring_plan.md",
        "H6 | USART3 Bluetooth port | 1 5V, 2 GND, 3 PB11/RX3, 4 PB10/TX3",
        "assembly USART3 connector pinout",
    ),
    RequiredText(
        "docs/near_term_vehicle_bringup_handoff.md",
        "full-rover operation remain `UNVERIFIED`.",
        "vehicle assembly evidence boundary",
    ),
    RequiredText(
        "docs/near_term_vehicle_bringup_handoff.md",
        "it must not be flashed as",
        "inert rover-control target warning",
    ),
    RequiredText(
        "docs/phase4c_agent_prompt.md",
        "Do not merge phase3.2e-hcsr04-bringup tip 17c6cd5 into main.",
        "generated HC-SR04 branch exclusion",
    ),
    RequiredText(
        "docs/phase4c_agent_prompt.md",
        "Do not commit or push unless explicitly requested.",
        "next-agent git authorization boundary",
    ),
    RequiredText(
        "evidence/hardware/vehicle_assembly_2026-07-23/vehicle_assembly_evidence.md",
        "FD4954180AE16CD45CA0ED9B50642BEF62AD84B1534065FA8E13EA7A34A5AD0C",
        "vehicle assembly response-document hash",
    ),
    RequiredText(
        "evidence/hardware/vehicle_assembly_2026-07-23/vehicle_assembly_evidence.md",
        "56 mm + 29.8 mm = 85.8 mm",
        "C1 scan-plane height evidence",
    ),
    RequiredText(
        "firmware/openrf1/app/config/board_config.h",
        "OPENRF1_WHEEL_DIAMETER_X10_MM ((uint32_t)790u)",
        "supplied wheel diameter without rounding",
    ),
    RequiredText(
        "firmware/openrf1/app/config/board_config.h",
        "OPENRF1_TRACK_WIDTH_X10_MM ((uint32_t)2170u)",
        "supplied track width without rounding",
    ),
)


FIRMWARE_FORBIDDEN_TEXTS: tuple[str, ...] = (
    "MOTOR_PWM_GPIO",
    "SoftwareSerial",
    "constexpr int kLidarRxPin = 20",
    "constexpr int kLidarTxPin = 21",
)


def validate_repo(repo_root: Path = SUBSYSTEM_ROOT) -> list[str]:
    """Return validation errors for the subsystem root."""
    root = repo_root.resolve()
    errors: list[str] = []
    contents = _collect_text_contents(root, errors)
    firmware_sources = _collect_firmware_sources(root, errors)
    errors.extend(validate_text_contents(contents, firmware_sources))
    return errors


def validate_text_contents(
    contents: Mapping[str, str],
    firmware_sources: Mapping[str, str],
) -> list[str]:
    """Validate already-loaded repository text content."""
    errors: list[str] = []
    for required in REQUIRED_TEXTS:
        content = contents.get(required.relative_path)
        if content is None:
            errors.append(f"{required.relative_path}: file is missing")
        elif required.text not in content:
            errors.append(
                f"{required.relative_path}: missing {required.description}: {required.text!r}"
            )

    _validate_phase_scope(contents, errors)
    _validate_firmware_sources(firmware_sources, errors)
    return errors


def _validate_phase_scope(contents: Mapping[str, str], errors: list[str]) -> None:
    readme = contents.get("README.md")
    project_spec = contents.get("PROJECT_SPEC.md")
    test_plan = contents.get("docs/test_plan.md")
    if readme is not None and "Phase 2.4" not in readme:
        errors.append("README.md: current Phase 2.4 scope is not stated")
    if project_spec is not None and "Phase 2.4 is software-only" not in project_spec:
        errors.append("PROJECT_SPEC.md: Phase 2.4 software-only exclusion is missing")
    if test_plan is not None and "test_hardware_lock_validation.py" not in test_plan:
        errors.append("docs/test_plan.md: hardware-lock regression test is missing")


def _validate_firmware_sources(
    firmware_sources: Mapping[str, str],
    errors: list[str],
) -> None:
    for relative, content in firmware_sources.items():
        for forbidden in FIRMWARE_FORBIDDEN_TEXTS:
            if forbidden in content:
                errors.append(f"{relative}: forbidden firmware text found: {forbidden!r}")


def _collect_text_contents(root: Path, errors: list[str]) -> dict[str, str]:
    paths = {required.relative_path for required in REQUIRED_TEXTS}
    paths.update({"README.md", "PROJECT_SPEC.md", "docs/test_plan.md"})
    contents: dict[str, str] = {}
    for relative_path in sorted(paths):
        content = _read_text(root, relative_path, errors)
        if content is not None:
            contents[relative_path] = content
    return contents


def _collect_firmware_sources(root: Path, errors: list[str]) -> dict[str, str]:
    firmware_root = root / "firmware"
    if not firmware_root.exists():
        errors.append("firmware: directory is missing")
        return {}
    sources: dict[str, str] = {}
    for path in firmware_root.rglob("*"):
        if path.is_file() and path.suffix in {".c", ".h", ".hpp", ".cpp", ".ino"}:
            relative = path.relative_to(root).as_posix()
            content = _read_text(root, relative, errors)
            if content is not None:
                sources[relative] = content
    return sources


def _read_text(root: Path, relative_path: str, errors: list[str]) -> str | None:
    path = root / relative_path
    if not path.exists():
        errors.append(f"{relative_path}: file is missing")
        return None
    try:
        return path.read_text(encoding="utf-8")
    except UnicodeDecodeError as exc:
        errors.append(f"{relative_path}: expected UTF-8 text: {exc}")
        return None


def main(argv: list[str] | None = None) -> int:
    args = argv if argv is not None else sys.argv[1:]
    root = Path(args[0]) if args else SUBSYSTEM_ROOT
    errors = validate_repo(root)
    if errors:
        print("Hardware lock validation FAILED")
        for error in errors:
            print(f"- {error}")
        return 1
    print("Hardware lock validation passed.")
    print(f"Checked subsystem root: {root.resolve()}")
    return 0


if __name__ == "__main__":
    raise SystemExit(main())
