terabitesyuex/ENGR1000P2_Mars-Scout-Rover/pc/tests/test_phase3_current_plan.py

from __future__ import annotations

from pathlib import Path


REPO_ROOT = Path(__file__).resolve().parents[2]


def test_phase31_current_plan_documents_core_boundaries():
    required = {
        "AGENTS.md": [
            "Phase 3.1 software work is complete",
            "Phase 3.2A software work is complete",
            "Phase 3.2B software work is complete",
            "Phase 3.2B physical sensor integration has not started",
            "No hardware result may be claimed without evidence",
        ],
        "README.md": [
            "mars_scout_stm32_sensor_telemetry",
            "simulate-stm32-sensors",
            "record-stm32-telemetry",
        ],
        "HARDWARE_LOCK.md": [
            "USER-CONFIRMED PLANNED CONNECTION",
            "HC-SR04 ECHO voltage compatibility",
            "TCRT5000 and Hall output polarity remains UNVERIFIED",
        ],
        "docs/stm32_sensor_protocol.md": [
            "mars_scout_stm32_sensor_telemetry",
            "timeout must not be represented as a valid zero-distance obstacle",
            "Hall sensor is for magnetic landmark/checkpoint detection",
        ],
        "docs/phase3_hardware_checklist.md": [
            "Do not mark checklist items complete automatically",
            "HC-SR04",
            "Evidence table",
        ],
    }

    missing: list[str] = []
    for relative, snippets in required.items():
        text = (REPO_ROOT / relative).read_text(encoding="utf-8")
        for snippet in snippets:
            if snippet not in text:
                missing.append(f"{relative}: {snippet}")

    assert missing == []


def test_phase32a_current_plan_documents_openrf1_bh1750_boundaries():
    required = {
        "README.md": [
            "OpenRF1 STM32F103RCT6",
            "simulate-bh1750-telemetry",
            "capture-stm32-serial",
            "MANUAL_EVIDENCE_VERIFIED",
        ],
        "HARDWARE_LOCK.md": [
            "OpenRF1 robot controller",
            "STM32F103RCT6",
            "PB1",
            "PC3",
            "BH1750 communication at configured address `0x23`",
        ],
        "docs/openrf1_bh1750_bringup.md": [
            "GY-302 VCC",
            "OpenRF1 PB1/SCL",
            "OpenRF1 PC3/SDA",
            "Do not invent a COM port",
        ],
        "docs/test_plan.md": [
            "phase3.2a",
            "Phase 3.2A automated tests do not open real COM ports",
        ],
    }

    missing: list[str] = []
    for relative, snippets in required.items():
        text = (REPO_ROOT / relative).read_text(encoding="utf-8")
        for snippet in snippets:
            if snippet not in text:
                missing.append(f"{relative}: {snippet}")

    assert missing == []


def test_phase32b_current_plan_documents_software_foundation_boundaries():
    required = {
        "README.md": [
            "Phase 3.2B",
            "OpenRF1_FullHardware.uvprojx",
            "live sensor/link behavior remain UNVERIFIED",
        ],
        "HARDWARE_LOCK.md": [
            "Phase 3.2B proposed full-hardware connection plan",
            "firmware/openrf1/full_hardware/",
            "Physical Phase 3.2B multisensor wiring",
        ],
        "docs/phase3_2b_full_hardware_foundation.md": [
            "Software foundation and Keil builds are SOFTWARE_VERIFIED",
            "Do not tie all I2C module VCC pins together",
            "Validate C1-to-ESP32 data transport",
        ],
        "docs/openrf1_phase32b_protocol.md": [
            "payload_length",
            "CRC-16/CCITT-FALSE",
            "a55a0101000034120403020102004f4b94fd",
        ],
        "docs/wiring.md": [
            "Phase 3.2B Proposed Full-Hardware Wiring",
            "Echo level protection is conditional",
        ],
    }

    missing: list[str] = []
    for relative, snippets in required.items():
        text = (REPO_ROOT / relative).read_text(encoding="utf-8")
        for snippet in snippets:
            if snippet not in text:
                missing.append(f"{relative}: {snippet}")

    assert missing == []


def test_phase32d_current_plan_documents_mpu6050_software_boundary():
    required = {
            "README.md": [
                "Phase 3.2D",
                "OpenRF1_MPU6050_Bringup.uvprojx",
                "I2C ACK/address `0x68`, WHO_AM_I `0x68`",
                "shared-I2C concurrency",
            ],
            "HARDWARE_LOCK.md": [
                "Phase 3.2D MPU6050 Bring-Up Boundary Status",
                "Objects_MPU6050_Bringup",
                "ACK/address, WHO_AM_I",
                "MANUAL_EVIDENCE_VERIFIED",
            ],
            "docs/openrf1_mpu6050_bringup.md": [
                "isolated VCC/GND/SCL/SDA/AD0 wiring",
                "WHO_AM_I register",
                "MANUAL_EVIDENCE_VERIFIED",
                "Remaining Limitations",
            ],
        "docs/test_plan.md": [
            "phase3.2d",
            "Phase 3.2D automated tests do not open real COM ports",
        ],
    }

    missing: list[str] = []
    for relative, snippets in required.items():
        text = (REPO_ROOT / relative).read_text(encoding="utf-8")
        for snippet in snippets:
            if snippet not in text:
                missing.append(f"{relative}: {snippet}")

    assert missing == []


def test_phase32e_current_plan_documents_hcsr04_software_boundary():
    required = {
        "README.md": [
            "Phase 3.2E",
            "OpenRF1_HCSR04_Bringup.uvprojx",
            "Do not connect HC-SR04 ECHO directly to CN6 pin 4",
        ],
        "HARDWARE_LOCK.md": [
            "Phase 3.2E HC-SR04 Bring-Up Boundary Status",
            "TRIG: PA5",
            "ECHO: PA4",
            "TIM6",
            "10 kOhm",
            "15 kOhm",
        ],
        "docs/openrf1_hcsr04_bringup.md": [
            "AUTHORITATIVE_VENDOR_DOCUMENTED",
            "CN6",
            "PA5_TRIG",
            "PA4_ECHO",
            "PHYSICAL_VERIFICATION_REQUIRED",
        ],
        "docs/test_plan.md": [
            "phase3.2e",
            "Phase 3.2E automated tests do not open real COM ports",
        ],
    }

    missing: list[str] = []
    for relative, snippets in required.items():
        text = (REPO_ROOT / relative).read_text(encoding="utf-8")
        for snippet in snippets:
            if snippet not in text:
                missing.append(f"{relative}: {snippet}")

    assert missing == []


def test_phase32f_current_plan_documents_ground_sensor_software_boundary():
    required = {
        "README.md": [
            "Phase 3.2F",
            "OpenRF1_GroundSensors_Bringup.uvprojx",
            "Do not connect Hall S directly to PB0",
        ],
        "HARDWARE_LOCK.md": [
            "Phase 3.2F Ground-Sensor Bring-Up Boundary Status",
            "signal 1 / X1 / PC4",
            "signal 2 / X2 / PC5",
            "signal 3 / X3 / PB0",
            "10 kOhm",
            "15 kOhm",
        ],
        "docs/openrf1_ground_sensors_bringup.md": [
            "AUTHORITATIVE_VENDOR_DOCUMENTED",
            "OpenRF1 four-channel tracking example",
            "schematic says PC14",
            "old example maps X4 to PB1",
            "PHYSICAL_VERIFICATION_REQUIRED",
        ],
        "docs/test_plan.md": [
            "phase3.2f",
            "Phase 3.2F automated tests do not open real COM ports",
        ],
    }

    missing: list[str] = []
    for relative, snippets in required.items():
        text = (REPO_ROOT / relative).read_text(encoding="utf-8")
        for snippet in snippets:
            if snippet not in text:
                missing.append(f"{relative}: {snippet}")

    assert missing == []
