terabitesyuex/ENGR1000P2_Mars-Scout-Rover/pc/tests/test_openrf1_vehicle_demo.py

from __future__ import annotations

import re
from pathlib import Path


ROOT = Path(__file__).resolve().parents[2]
SOURCE_DIR = ROOT / "firmware" / "openrf1" / "vehicle_demo"
PROJECT = ROOT / "firmware" / "openrf1" / "keil" / "OpenRF1_VehicleDemo.uvprojx"


def _read(name: str) -> str:
    return (SOURCE_DIR / name).read_text(encoding="utf-8")


def _constant(source: str, name: str) -> int:
    match = re.search(rf"#define\s+{name}\s+\(\(\w+_t\)(\d+)u\)", source)
    assert match is not None, name
    return int(match.group(1))


def test_user_confirmed_pin_profile_is_centralized() -> None:
    config = _read("demo_config.h")

    assert '"hardware_group_3us_user_confirmed"' in config
    assert 'OPENRF1_DEMO_US_LEFT_TRIGGER_PIN "PB9"' in config
    assert 'OPENRF1_DEMO_US_LEFT_ECHO_PIN "PB8"' in config
    assert 'OPENRF1_DEMO_US_CENTER_TRIGGER_PIN "PB5"' in config
    assert 'OPENRF1_DEMO_US_CENTER_ECHO_PIN "PB4"' in config
    assert 'OPENRF1_DEMO_US_RIGHT_TRIGGER_PIN "PD2"' in config
    assert 'OPENRF1_DEMO_US_RIGHT_ECHO_PIN "PC11"' in config
    assert 'OPENRF1_DEMO_HALL_PIN "PB0"' in config
    assert "User-confirmed current demo mapping" in config
    assert "Electrical ECHO voltage safety remains unverified" in config


def test_safety_and_ultrasonic_timing_constants() -> None:
    config = _read("demo_config.h")

    assert _constant(config, "OPENRF1_DEMO_FRONT_STOP_MM") == 250
    assert _constant(config, "OPENRF1_DEMO_SIDE_STOP_MM") == 200
    assert _constant(config, "OPENRF1_DEMO_HAZARD_CONFIRM_COUNT") == 2
    assert _constant(config, "OPENRF1_DEMO_COMMAND_WATCHDOG_MS") == 2000
    assert _constant(config, "OPENRF1_DEMO_SENSOR_MAX_AGE_MS") == 500
    assert _constant(config, "OPENRF1_DEMO_TRIGGER_PULSE_US") >= 10
    assert _constant(config, "OPENRF1_DEMO_ECHO_TIMEOUT_US") == 30000
    assert _constant(config, "OPENRF1_DEMO_INTER_CHANNEL_GAP_US") == 35000


def test_distance_conversion_vectors_and_timeout_boundary() -> None:
    def distance_mm(pulse_us: int) -> int | None:
        if pulse_us <= 0 or pulse_us >= 30_000:
            return None
        return (pulse_us * 343 + 1000) // 2000

    assert distance_mm(0) is None
    assert distance_mm(1000) == 172
    assert distance_mm(2000) == 343
    assert distance_mm(10_000) == 1715
    assert distance_mm(30_000) is None


def test_sensor_failure_and_stale_data_are_fail_closed() -> None:
    control = _read("obstacle_control.c")

    safety_check = control.index("if (all_samples_current(samples, now_ms) == 0u)")
    state_switch = control.index("switch (controller->state)")
    assert safety_check < state_switch
    assert "enter_sensor_fault(controller, now_ms);" in control
    assert "controller->armed = 0u;" in control
    assert "controller->motion = DEMO_MOTION_STOP;" in control
    assert "DEMO_CONTROL_SENSOR_FAULT" in control
    assert "DEMO_CONTROL_WATCHDOG_FAULT" in control
    assert "format_distance" in _read("main_vehicle_demo.c")
    assert 'snprintf(output, 6u, "null")' in _read("main_vehicle_demo.c")


def test_motion_requires_explicit_arm_start_and_heartbeat() -> None:
    main = _read("main_vehicle_demo.c")
    control = _read("obstacle_control.c")

    assert 'strings_equal(command, "ARM")' in main
    assert 'strings_equal(command, "START")' in main
    assert 'strings_equal(command, "HEARTBEAT")' in main
    assert "DEMO_COMMAND_STOP" in main
    assert "OPENRF1_DEMO_COMMAND_WATCHDOG_MS" in control
    assert "controller->last_heartbeat_ms" in control
    assert "if (any_hazard(samples) != 0u)" in control
    assert "enter_state(controller, DEMO_CONTROL_READY, now_ms);" in control
    assert "DEMO_MOTION_FORWARD" not in main.split("demo_platform_init", maxsplit=1)[0]


def test_ultrasonic_runtime_is_nonblocking_and_staggered() -> None:
    ultrasonic = _read("ultrasonic_array.c")
    platform = _read("platform_vehicle_demo.c")
    start_channel = ultrasonic.split("static void start_channel", maxsplit=1)[1].split(
        "void demo_ultrasonic_array_service", maxsplit=1
    )[0]

    assert "while (" not in ultrasonic
    assert "DEMO_ULTRASONIC_WAIT_LOW" in ultrasonic
    assert "DEMO_ULTRASONIC_WAIT_RISE" in ultrasonic
    assert "DEMO_ULTRASONIC_WAIT_FALL" in ultrasonic
    assert "OPENRF1_DEMO_INTER_CHANNEL_GAP_US" in ultrasonic
    assert "DWT" not in platform
    assert platform.count("AFIO->MAPR =") == 1
    assert "mapr = AFIO->MAPR;" in platform
    assert "mapr &= ~(tim2_remap_mask | swj_config_mask);" in platform
    assert "gpio_configure(g_echo_pins[index].port, g_echo_pins[index].pin, 0x08u);" in platform
    assert "g_timer6_overflows" in platform
    assert "TIM6_IRQHandler" in platform
    assert "USART_CR1_TXEIE" in platform
    assert "Keep the last completed sample valid" in start_channel
    assert "channel->status = DEMO_SENSOR_NOT_READY" not in start_channel
    assert "channel->distance_mm = 0u" not in start_channel


def test_hall_input_is_sampled_independently_and_does_not_drive_motion() -> None:
    config = _read("demo_config.h")
    hall = _read("hall_input.c")
    main = _read("main_vehicle_demo.c")
    platform = _read("platform_vehicle_demo.c")

    assert _constant(config, "OPENRF1_DEMO_HALL_SAMPLE_PERIOD_MS") == 5
    assert _constant(config, "OPENRF1_DEMO_HALL_DEBOUNCE_SAMPLES") == 4
    assert _constant(config, "OPENRF1_DEMO_HALL_BASELINE_SAMPLES") == 20
    assert _constant(config, "OPENRF1_DEMO_TELEMETRY_BUFFER_BYTES") == 640
    assert _constant(config, "OPENRF1_DEMO_UART_TX_BUFFER_BYTES") == 1024
    assert "demo_hall_input_update" in hall
    assert "while (" not in hall
    assert "candidate_started_ms" in hall
    assert "last_landmark_timestamp_ms = input->candidate_started_ms" in hall
    assert "event_pending = 1u" in hall
    assert "landmark_count" in hall
    assert "demo_tx_ring_holds_one_telemetry_record" in config
    assert "gpio_configure(g_hall_pin.port, g_hall_pin.pin, 0x04u);" in platform
    assert "return pin_read(&g_hall_pin);" in platform
    assert "demo_hall_input_update(&g_hall, demo_platform_hall_read(), now_ms);" in main
    assert "g_next_hall_sample_ms = now_ms + OPENRF1_DEMO_HALL_SAMPLE_PERIOD_MS;" in main
    assert "g_next_hall_sample_ms += OPENRF1_DEMO_HALL_SAMPLE_PERIOD_MS;" not in main
    assert "scheduler delay cannot fake stable samples" in main
    assert r'\"hall_raw_level\"' in main
    assert r'\"hall_debounced_level\"' in main
    assert r'\"message_type\":\"vehicle_demo_hall_event\"' in main
    assert r'\"hall_landmark_count\"' in main
    assert "demo_hall_input_clear_pending_event" in main
    assert "g_hall" not in _read("obstacle_control.c")
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
