terabitesyuex/ENGR1000P2_Mars-Scout-Rover/(commit log)

2026-07-15 feat: phase 2.3 synthetic lidar visualization
2026-07-15 feat: phase 3.1 stm32 sensor telemetry foundation
2026-07-16 docs: revise phase 3.2b module power and level requirements
2026-07-18 feat: add isolated ground sensor bringup firmware
2026-07-18 feat: add phase 4a kinematics and odometry foundation
2026-07-19 fix: rebaseline project for one RPLIDAR C1
    [audit_single_c1_inventory.py, test_c1_pc_direct.py, test_recording.py, test_single_c1_inventory.py, validate_current_plan.py, validate_hardware_lock.py]
2026-07-19 Add MPU6050 startup gyro calibration
2026-07-20 fix(serial): avoid resetting STM32 when opening capture port
    [test_stm32_serial_capture.py]
2026-07-20 test(mpu6050): add deterministic telemetry fixtures
    [test_openrf1_mpu6050_bringup.py]
2026-07-20 fix(verify): scope historical phase firmware audits
    [audit_phase4a.py, audit_phase4b.py, test_phase4a_foundation.py, test_phase4b_foundation.py]
2026-07-21 fix(mpu6050): address PR review findings
    [audit_phase32d.py, test_phase3_current_plan.py, test_stm32_serial_capture.py, validate_current_plan.py]
2026-07-21 fix(hcsr04): make telemetry framing and protocol safe
    [board_config.h, hcsr04.c, hcsr04.h, main_hcsr04_bringup.c, telemetry_hcsr04_bringup.c, test_openrf1_hcsr04_bringup.py, test_openrf1_hcsr04_protocol.py]
2026-07-21 test(ground-sensors): record isolated TCRT5000 evidence
2026-07-22 test(lidar): record phase 2.5 physical evidence
2026-07-22 docs: lock rover wiring and battery evidence
2026-07-22 docs: add vehicle-ready wiring checklist
2026-07-23 docs: record vehicle assembly geometry evidence
2026-08-02 feat: hall&encoders
